roblim/fused_glass_lighting/hardware/kicad/fgl_g2/fgl_g2_3d.png

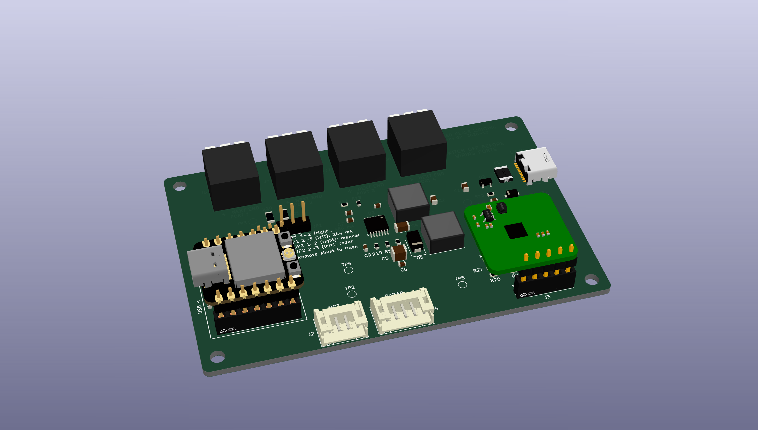
hardware/kicad/fgl_g2/fgl_g2_3d.png
