roblim/fused_glass_lighting/hardware/kicad/fgl_g2/fgl_g2_layout.png

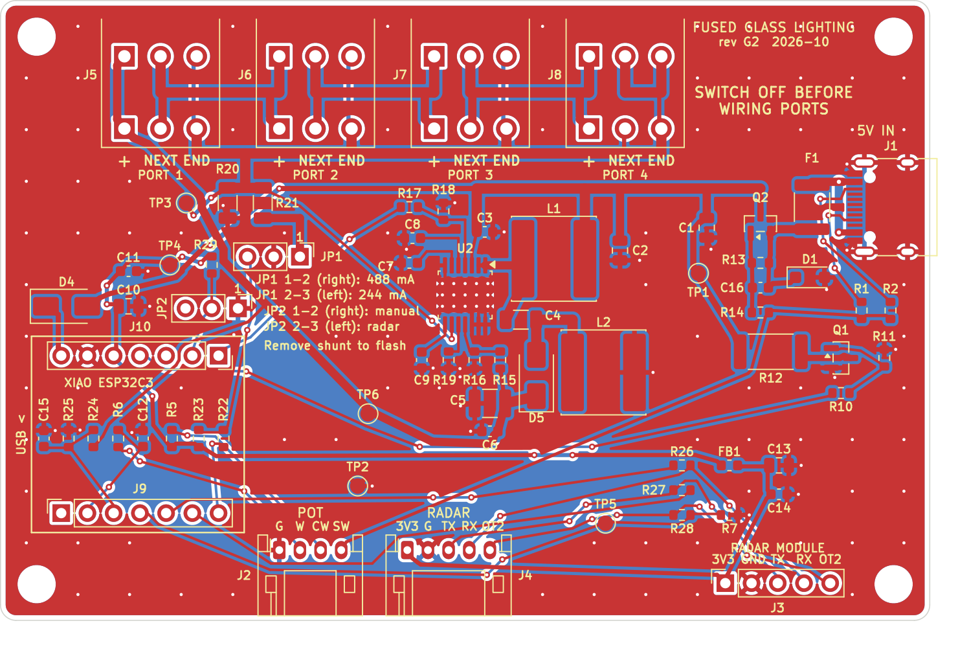
hardware/kicad/fgl_g2/fgl_g2_layout.png
