roblim/fused_glass_lighting/hardware/kicad/fgl_g2/bom.csv

Qty | References | Value | Footprint | MPN | Manufacturer | LCSC | Assembly
4 | C1,C2,C10,C13 | 10u 25V | C_0805_2012Metric | CL21A106KAYNNNE | Samsung | C15850 | JLCPCB
8 | C3,C8,C9,C11,C12,C14,C15,C16 | 100n 50V | C_0603_1608Metric | CC0603KRX7R9BB104 | YAGEO | C14663 | JLCPCB
1 | C4 | 10u 50V | C_1206_3216Metric | CL31A106KBHNNNE | Samsung | C13585 | JLCPCB
1 | C5 | 10u 100V | C_1210_3225Metric | GRM32EC72A106KE05L | Murata | C576517 | JLCPCB
1 | C6 | 100n 100V | C_0603_1608Metric | CL10B104KC8NNNC | Samsung | C15725 | JLCPCB
1 | C7 | 1u 50V | C_0603_1608Metric | CL10A105KB8NNNC | Samsung | C15849 | JLCPCB
1 | D1 | SMF6.0A | D_SOD-123F | SMF6.0A | Jingdao | C178260 | DNP
1 | D4 | SS14 | D_SMA | SS14 | MDD | C2480 | JLCPCB
1 | D5 | SS36 | D_SMA | SS36 | LGE | C2903825 | JLCPCB
1 | F1 | 2A hold | Fuse_1812_4532Metric | SMD1812B200TF/16 | Brightking | C269145 | JLCPCB
1 | FB1 | 600R@100MHz | L_0603_1608Metric | GZ1608D601TF | Sunlord | C1002 | JLCPCB
1 | J1 | USB-C (from bank) | USB_C_Receptacle_HRO_TYPE-C-31-M-12 | TYPE-C-31-M-12 | Korean Hroparts Elec | C165948 | JLCPCB
1 | J2 | POT 100k lin + SW | JST_PH_S4B-PH-K_1x04_P2.00mm_Horizontal | S4B-PH-K-S(LF)(SN) | JST | C157926 | JLCPCB
1 | J3 | LD2410S socket | PinSocket_1x05_P2.54mm_Vertical | HC-PM254-5.0H-1x5PZ | Hong Cheng | C27985230 | JLCPCB
1 | J4 | LD2410S cable | JST_PH_S5B-PH-K_1x05_P2.00mm_Horizontal | S5B-PH-K-S(LF)(SN) | JST | C157923 | JLCPCB
1 | J5 | PORT 1 | TerminalBlock_JILN_JL212R-3.5-03P_Horizontal | DG212R-THR-3.5-03P-13-1000A(H) | DEGSON | C7603454 | JLCPCB
1 | J6 | PORT 2 | TerminalBlock_JILN_JL212R-3.5-03P_Horizontal | DG212R-THR-3.5-03P-13-1000A(H) | DEGSON | C7603454 | JLCPCB
1 | J7 | PORT 3 | TerminalBlock_JILN_JL212R-3.5-03P_Horizontal | DG212R-THR-3.5-03P-13-1000A(H) | DEGSON | C7603454 | JLCPCB
1 | J8 | PORT 4 | TerminalBlock_JILN_JL212R-3.5-03P_Horizontal | DG212R-THR-3.5-03P-13-1000A(H) | DEGSON | C7603454 | JLCPCB
1 | J9 | XIAO socket 1-7 | PinSocket_1x07_P2.54mm_Vertical | HC-PM254-5.0H-1x7PZ | Hong Cheng | C27985232 | JLCPCB
1 | J10 | XIAO socket 8-14 | PinSocket_1x07_P2.54mm_Vertical | HC-PM254-5.0H-1x7PZ | Hong Cheng | C27985232 | JLCPCB
1 | JP1 | ISEL | PinHeader_1x03_P2.54mm_Vertical | 2.54-1*3P | BOOMELE | C49257 | JLCPCB
2 | JP1-shunt, JP2-shunt | 2.54 mm shunt for JP1 / JP2 | (loose part, open top) | 2.54 | BOOMELE | C5305 | loose
1 | JP2 | RADAR_MODE | PinHeader_1x03_P2.54mm_Vertical | 2.54-1*3P | BOOMELE | C49257 | JLCPCB
2 | L1,L2 | 10uH | L_Sunlord_SWPA8040S | SWPA8040S100MT | Sunlord | C37429 | JLCPCB
1 | Q1 | AO3400A | SOT-23 | AO3400A | AOS | C20917 | JLCPCB
1 | Q2 | AO3401A | SOT-23 | AO3401A | AOS | C15127 | JLCPCB
3 | R1,R2,R16 | 5.1k 1% | R_0603_1608Metric | 0603WAF5101T5E | UNI-ROYAL | C23186 | JLCPCB
1 | R5 | 47k 1% | R_0603_1608Metric | 0603WAF4702T5E | UNI-ROYAL | C25819 | JLCPCB
6 | R6,R17,R22,R26,R27,R28 | 1k 1% | R_0603_1608Metric | 0603WAF1001T5E | UNI-ROYAL | C21190 | JLCPCB
4 | R7,R11,R13,R23 | 100k 1% | R_0603_1608Metric | 0603WAF1003T5E | UNI-ROYAL | C25803 | JLCPCB
1 | R10 | 100R 1% | R_0603_1608Metric | 0603WAF1000T5E | UNI-ROYAL | C22775 | JLCPCB
1 | R12 | 33R 1% 1W | R_2512_6332Metric | 25121WF330JT4E | UNI-ROYAL | C53728 | JLCPCB
2 | R14,R25 | 10k 1% | R_0603_1608Metric | 0603WAF1002T5E | UNI-ROYAL | C25804 | JLCPCB
1 | R15 | 110k 1% | R_0603_1608Metric | 0603WAF1103T5E | UNI-ROYAL | C25805 | JLCPCB
1 | R18 | 2.2k 1% | R_0603_1608Metric | 0603WAF2201T5E | UNI-ROYAL | C4190 | JLCPCB
1 | R19 | 82k 1% | R_0603_1608Metric | 0603WAF8202T5E | UNI-ROYAL | C23254 | JLCPCB
2 | R20,R21 | 0.82R 1% | R_1206_3216Metric | 1206W4F820LT5E | UNI-ROYAL | C30568 | JLCPCB
1 | R24 | 120k 1% | R_0603_1608Metric | 0603WAF1203T5E | UNI-ROYAL | C25808 | JLCPCB
1 | R29 | 10k | R_0603_1608Metric | 0603WAF1002T5E | UNI-ROYAL | C25804 | JLCPCB
1 | U1 | XIAO ESP32C3 | (plugs into J9/J10; pre-soldered headers SKU) | 102010633 | Seeed Studio |  | hand
1 | U2 | TPS61500PWPR | Texas_HTSSOP-14-1EP_4.4x5mm_P0.65mm_EP3.4x5mm_Mask3.155x3.255mm_ThermalVias | TPS61500PWPR | TI | C71160 | JLCPCB
