roblim/fused_glass_lighting/hardware/kicad/fgl_g1/bom.csv

Qty | References | Value | Footprint | MPN | Manufacturer | LCSC | Assembly
4 | C1,C2,C3,C8 | 10u 25V | C_0805_2012Metric | CL21A106KAYNNNE | Samsung | C15850 | JLCPCB
4 | C4,C5,C6,C9 | 100n | C_0603_1608Metric | CC0603KRX7R9BB104 | YAGEO | C14663 | JLCPCB
1 | C7 | 1u | C_0603_1608Metric | CL10A105KB8NNNC | Samsung | C15849 | JLCPCB
1 | D1 | SMF6.0A | D_SOD-123F | SMF6.0A | Jingdao | C178260 | DNP
3 | D2,D3,D4 | SS14 | D_SMA | SS14 | MDD | C2480 | JLCPCB
1 | F1 | 0.75A hold | Fuse_1206_3216Metric | 1206L075THYR | Littelfuse | C99563 | JLCPCB
1 | J1 | USB-C (from bank) | USB_C_Receptacle_HRO_TYPE-C-31-M-12 | TYPE-C-31-M-12 | Korean Hroparts Elec | C165948 | JLCPCB
1 | J2 | POT 100k lin | JST_PH_S3B-PH-K_1x03_P2.00mm_Horizontal | S3B-PH-K-S(LF)(SN) | JST | C157929 | hand
1 | J3 | LD2410S | JST_PH_S5B-PH-K_1x05_P2.00mm_Horizontal | S5B-PH-K-S(LF)(SN) | JST | C157923 | hand
1 | J4 | FILAMENT 1 | JST_PH_S2B-PH-K_1x02_P2.00mm_Horizontal | S2B-PH-K-S(LF)(SN) | JST | C173752 | hand
1 | J5 | FILAMENT 2 | JST_PH_S2B-PH-K_1x02_P2.00mm_Horizontal | S2B-PH-K-S(LF)(SN) | JST | C173752 | hand
2 | L1,L2 | 47uH | L_Sunlord_SWPA6045S | SWPA6045S470MT | Sunlord | C36414 | JLCPCB
1 | Q1 | AO3400A | SOT-23 | AO3400A | AOS | C20917 | JLCPCB
2 | R1,R2 | 5.1k 1% | R_0603_1608Metric | 0603WAF5101T5E | UNI-ROYAL | C23186 | JLCPCB
2 | R3,R4 | 0.33R 1% | R_1206_3216Metric | 1206W4F330LT5E | UNI-ROYAL | C25337 | JLCPCB
1 | R5 | 47k 1% | R_0603_1608Metric | 0603WAF4702T5E | UNI-ROYAL | C25819 | JLCPCB
1 | R6 | 1k | R_0603_1608Metric | 0603WAF1001T5E | UNI-ROYAL | C21190 | JLCPCB
2 | R7,R11 | 100k | R_0603_1608Metric | 0603WAF1003T5E | UNI-ROYAL | C25803 | JLCPCB
1 | R8 | 2.2k 1% | R_0603_1608Metric | 0603WAF2201T5E | UNI-ROYAL | C4190 | JLCPCB
1 | R9 | 10k 1% | R_0603_1608Metric | 0603WAF1002T5E | UNI-ROYAL | C25804 | JLCPCB
1 | R10 | 100R | R_0603_1608Metric | 0603WAF1000T5E | UNI-ROYAL | C22775 | JLCPCB
1 | R12 | 33R 1W 2512 | R_2512_6332Metric | 25121WF330JT4E | UNI-ROYAL | C53728 | JLCPCB
1 | U1 | XIAO ESP32C3 | XIAO_ESP32C3_Castellated | 113991054 | Seeed Studio |  | hand
2 | U2,U3 | AL8860WT-7 | TSOT-23-5 | AL8860WT-7 | Diodes Inc | C125330 | JLCPCB
