roblim/fused_glass_lighting/hardware/kicad/fgl_g2/fgl_g2_assembly.pdf

## J6 R²⁰

# H2 R²²

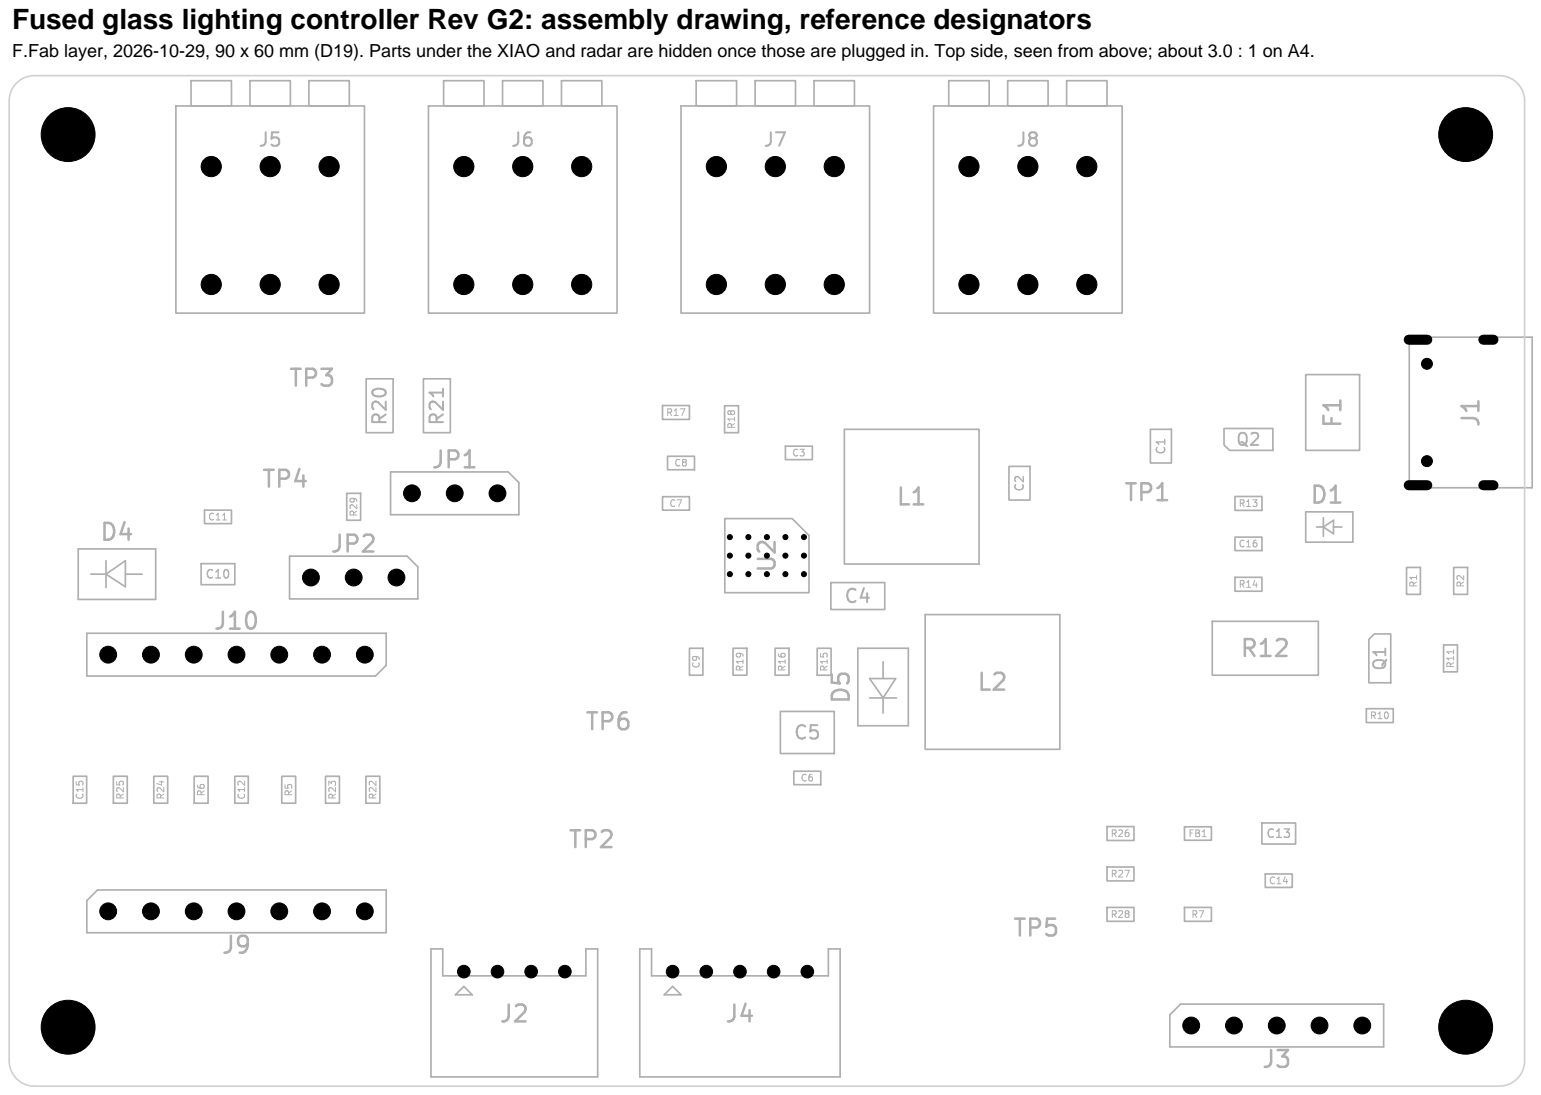
[picture p3: page 1]

Fused glass lighting controller Rev G2: assembly drawing, reference designators
F.Fab layer, 2026-10-29, 90 x 60 mm (D19). Parts under the XIAO and radar are hidden once those are plugged in. Top side, seen from above; about 3.0 : 1 on A4.

# Fused glass lighting controller Rev G2: parts by reference

From bom.csv, 2026-10-29. "Assembly" says who fits the part: JLCPCB, or you (plug-in modules, the JP1 and JP2 shunts).

C1 | 10u 25V | CL21A106KAYNNNE
C2 | 10u 25V | CL21A106KAYNNNE
C3 | 100n 50V | CC0603KRX7R9BB104
C4 | 10u 50V | CL31A106KBHNNNE
C5 | 10u 100V | GRM32EC72A106KE05L
C6 | 100n 100V | CL10B104KC8NNNC
C7 | 1u 50V | CL10A105KB8NNNC
C8 | 100n 50V | CC0603KRX7R9BB104
C9 | 100n 50V | CC0603KRX7R9BB104
C10 | 10u 25V | CL21A106KAYNNNE
C11 | 100n 50V | CC0603KRX7R9BB104
C12 | 100n 50V | CC0603KRX7R9BB104
C13 | 10u 25V | CL21A106KAYNNNE
C14 | 100n 50V | CC0603KRX7R9BB104
C15 | 100n 50V | CC0603KRX7R9BB104
C16 | 100n 50V | CC0603KRX7R9BB104
D1 | SMF6.0A | SMF6.0A [DNP]
D4 | SS14 | SS14
D5 | SS36 | SS36
F1 | 2A hold | SMD1812B200TF/16
FB1 | 600R@100MHz | GZ1608D601TF
J1 | USB-C (from bank) | TYPE-C-31-M-12
J2 | POT 100k lin + SW | S4B-PH-K-S(LF)(SN)
J3 | LD2410S socket | HC-PM254-5.0H-1x5PZ
J4 | LD2410S cable | S5B-PH-K-S(LF)(SN)
J5 | PORT 1 | DG212R-THR-3.5-03P-13-
J6 | PORT 2 | DG212R-THR-3.5-03P-13-
J7 | PORT 3 | DG212R-THR-3.5-03P-13-
J8 | PORT 4 | DG212R-THR-3.5-03P-13-
J9 | XIAO socket 1-7 | HC-PM254-5.0H-1x7PZ
J10 | XIAO socket 8-14 | HC-PM254-5.0H-1x7PZ
JP1 | ISEL | 2.54-1*3P

### JP1-shunt 2.54 mm shunt for JP1 / JP22.54 [loose] JP2-shunt 2.54 mm shunt for JP1 / JP22.54 [loose]

JP2 | RADAR_MODE | 2.54-1*3P
L1 | 10uH | SWPA8040S100MT
L2 | 10uH | SWPA8040S100MT
Q1 | AO3400A | AO3400A
Q2 | AO3401A | AO3401A
R1 | 5.1k 1% | 0603WAF5101T5E
R2 | 5.1k 1% | 0603WAF5101T5E
R5 | 47k 1% | 0603WAF4702T5E
R6 | 1k 1% | 0603WAF1001T5E
R7 | 100k 1% | 0603WAF1003T5E
R10 | 100R 1% | 0603WAF1000T5E
R11 | 100k 1% | 0603WAF1003T5E
R12 | 33R 1% 1W | 25121WF330JT4E
R13 | 100k 1% | 0603WAF1003T5E
R14 | 10k 1% | 0603WAF1002T5E
R15 | 110k 1% | 0603WAF1103T5E
R16 | 5.1k 1% | 0603WAF5101T5E
R17 | 1k 1% | 0603WAF1001T5E
R18 | 2.2k 1% | 0603WAF2201T5E
R19 | 82k 1% | 0603WAF8202T5E
R20 | 0.82R 1% | 1206W4F820LT5E
R21 | 0.82R 1% | 1206W4F820LT5E
R22 | 1k 1% | 0603WAF1001T5E
R23 | 100k 1% | 0603WAF1003T5E
R24 | 120k 1% | 0603WAF1203T5E
R25 | 10k 1% | 0603WAF1002T5E
R26 | 1k 1% | 0603WAF1001T5E
R27 | 1k 1% | 0603WAF1001T5E
R28 | 1k 1% | 0603WAF1001T5E
R29 | 10k | 0603WAF1002T5E
U1 | XIAO ESP32C3 | 113991054 [hand]
U2 | TPS61500PWPR | TPS61500PWPR
