roblim/fused_glass_lighting/hardware/kicad/fgl_g1/verification.txt

PASS: 24 nets, 106 connections, 11 no-connects, 46 parts; footprints and BOM fields OK
