roblim/fused_glass_lighting/hardware/kicad/fgl_rev_f/verification.txt

PASS: 19 nets, 62 connections, 5 no-connects, 22 parts; footprint/BOM checks not applicable
