roblim/fused_glass_lighting/hardware/kicad/fgl_g2/fgl_g2.pdf

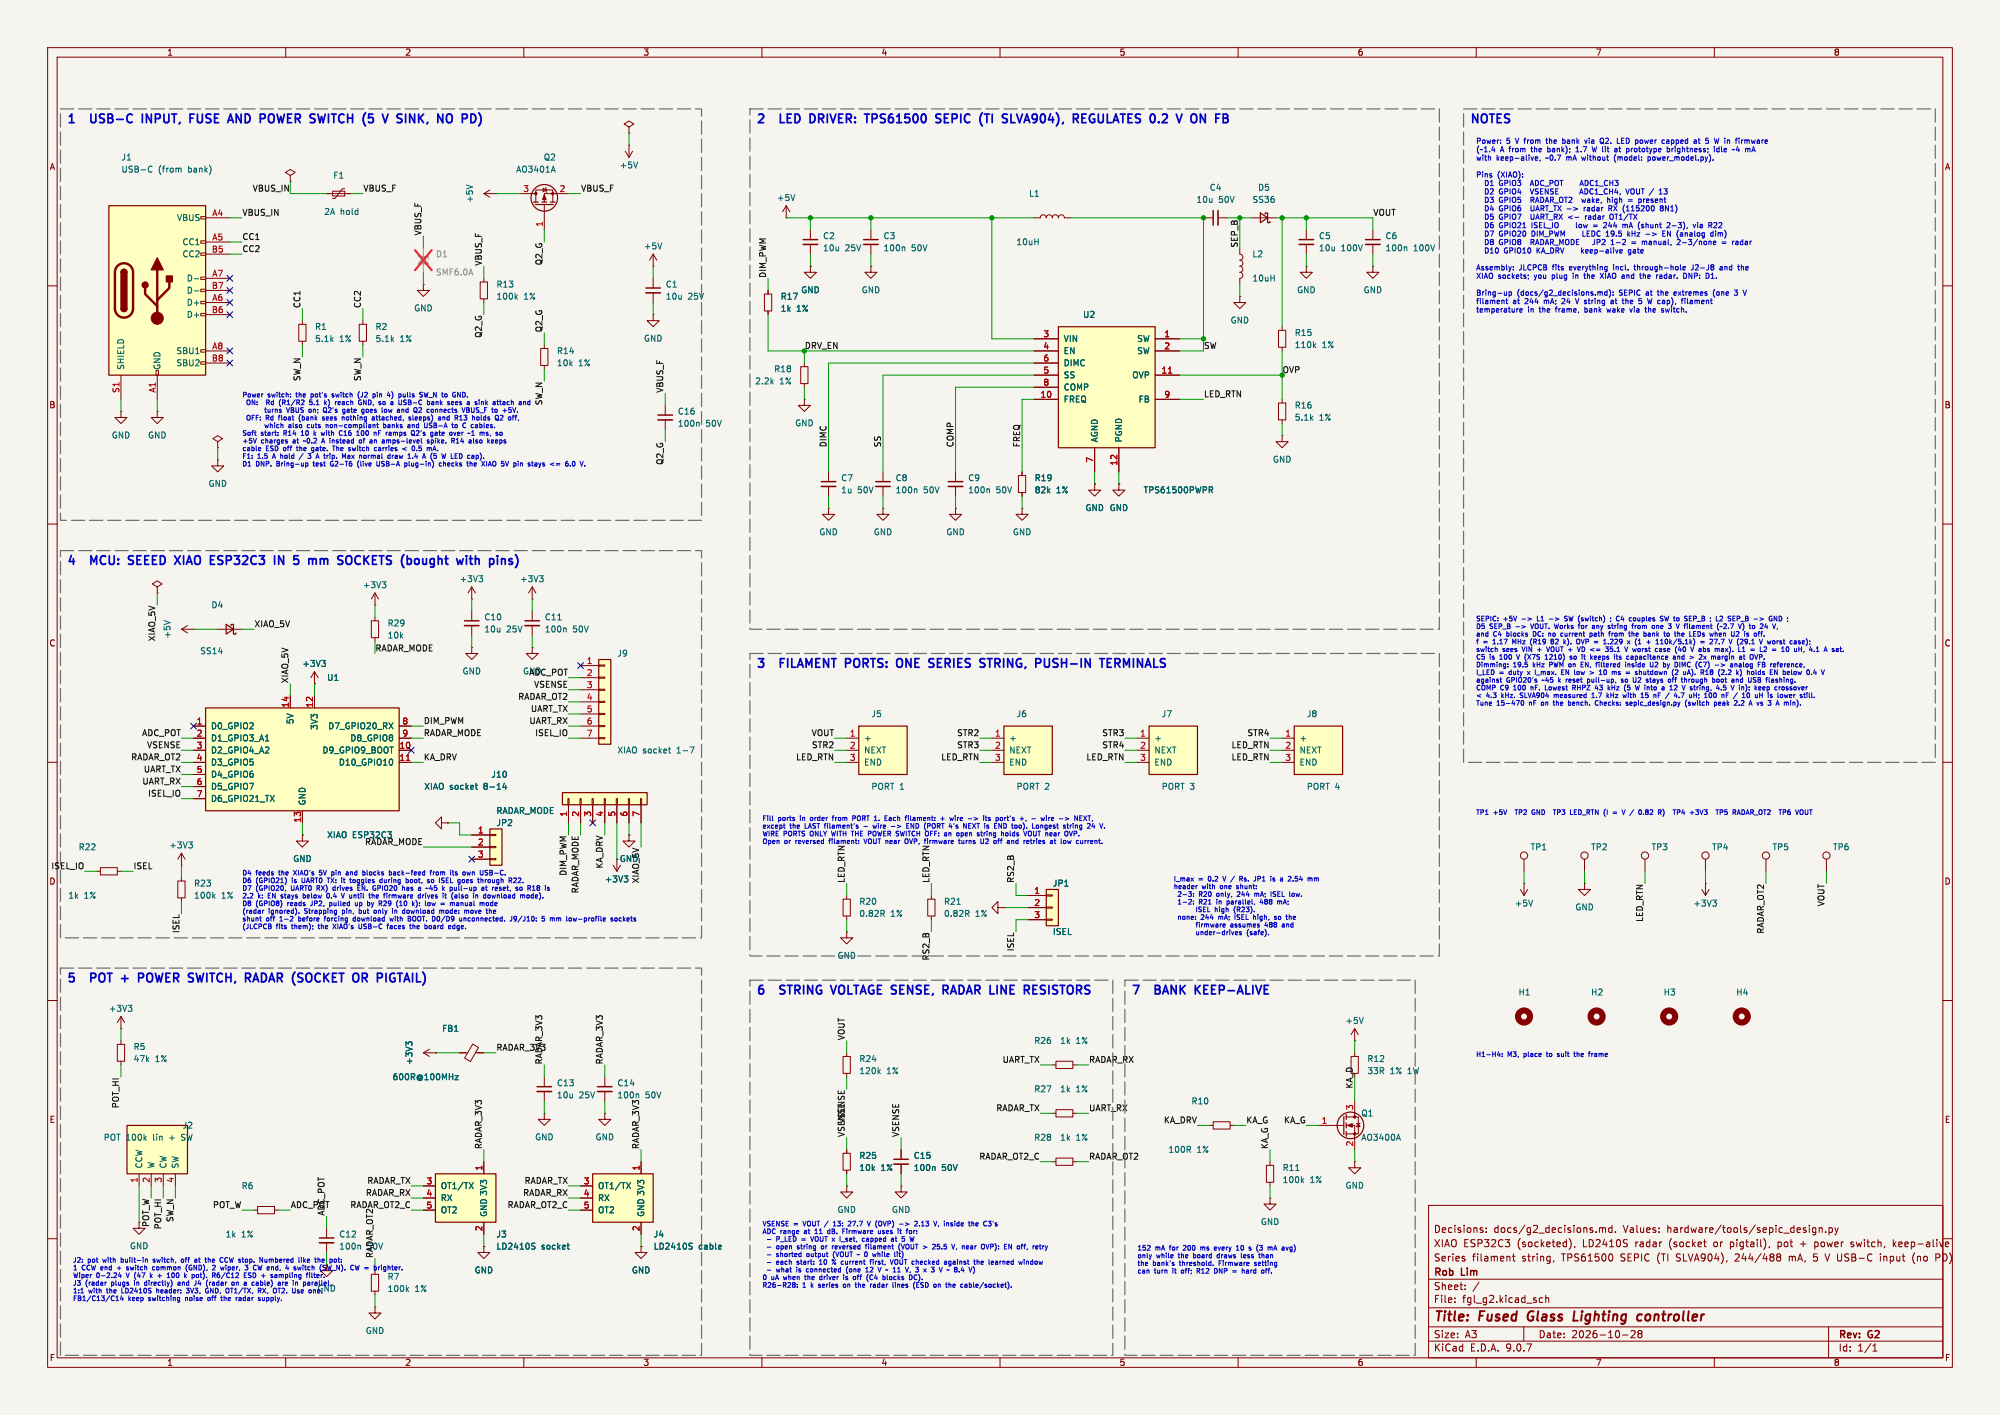
[picture p4: page 1]

Power: 5 V from the bank via Q2. LED power capped at 5 W in firmware

7 PGND 12 SW 1 SW 2 OVP 11 FB 9 U2 TPS61500PWPR

7 PGND 12 SW 1 SW 2 OVP 11 FB 9 R19

ISEL high (R23). none: 244 mA; ISEL high, so the

- shorted output (VOUT ~ 0 while lit)

152 mA for 200 ms every 10 s (3 mA avg) only while the board draws less than
