roblim/fused_glass_lighting/hardware/kicad/fgl_g1/fgl_g1.pdf

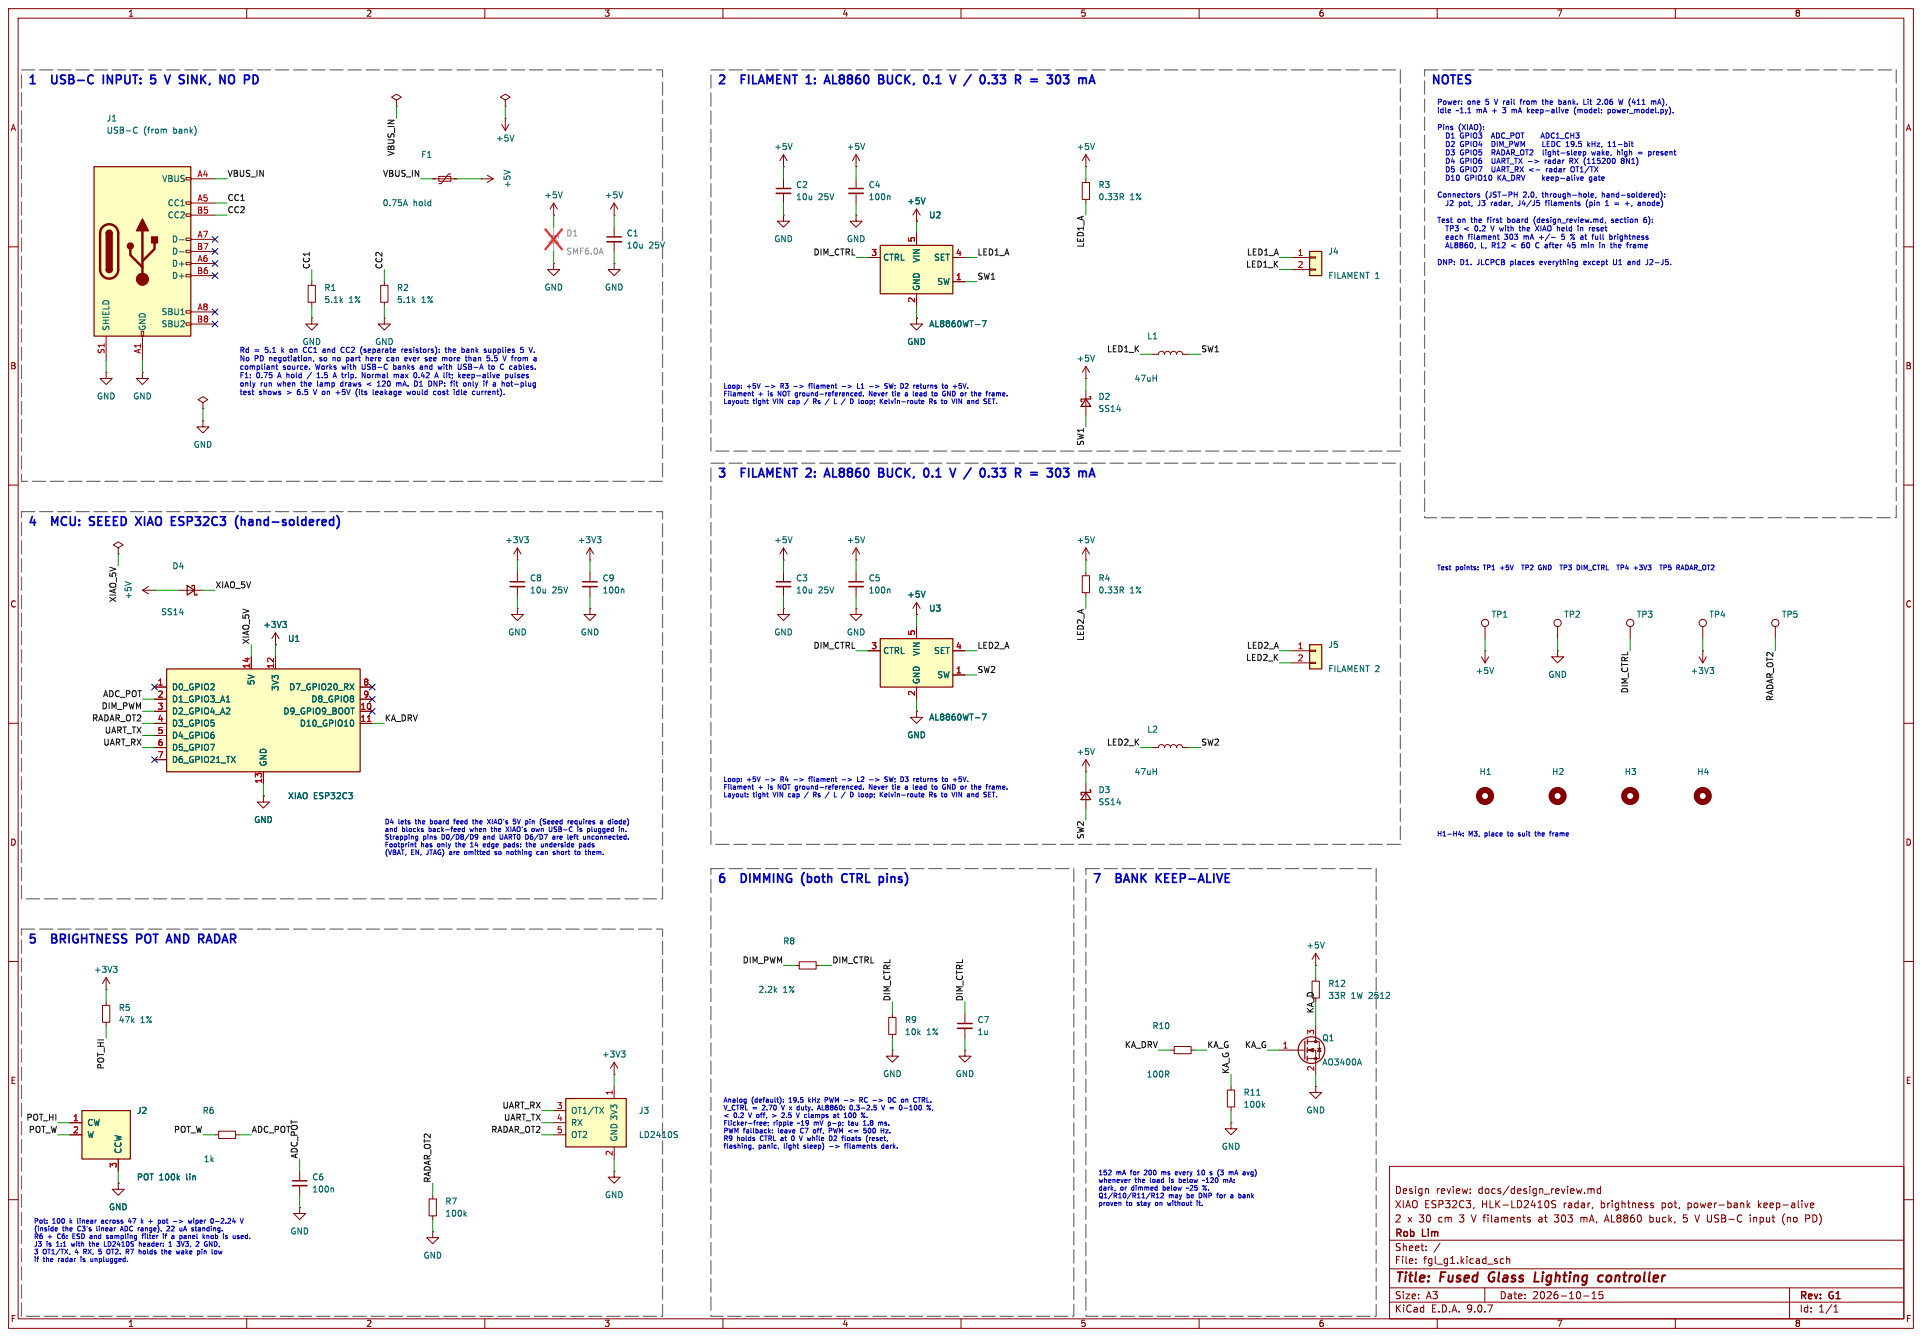
[picture p5: page 1]

Power: one 5 V rail from the bank. Lit 2.06 W (411 mA),

2 SET 4 SW 1 +5V U2AL8860WT-7 CTRL 3 VIN

4 MCU: SEEED XIAO ESP32C3 (hand-soldered)

Design review: docs/design_review.md R12
