roblim/fused_glass_lighting/hardware/kicad/fgl_rev_f/fgl_rev_f.pdf

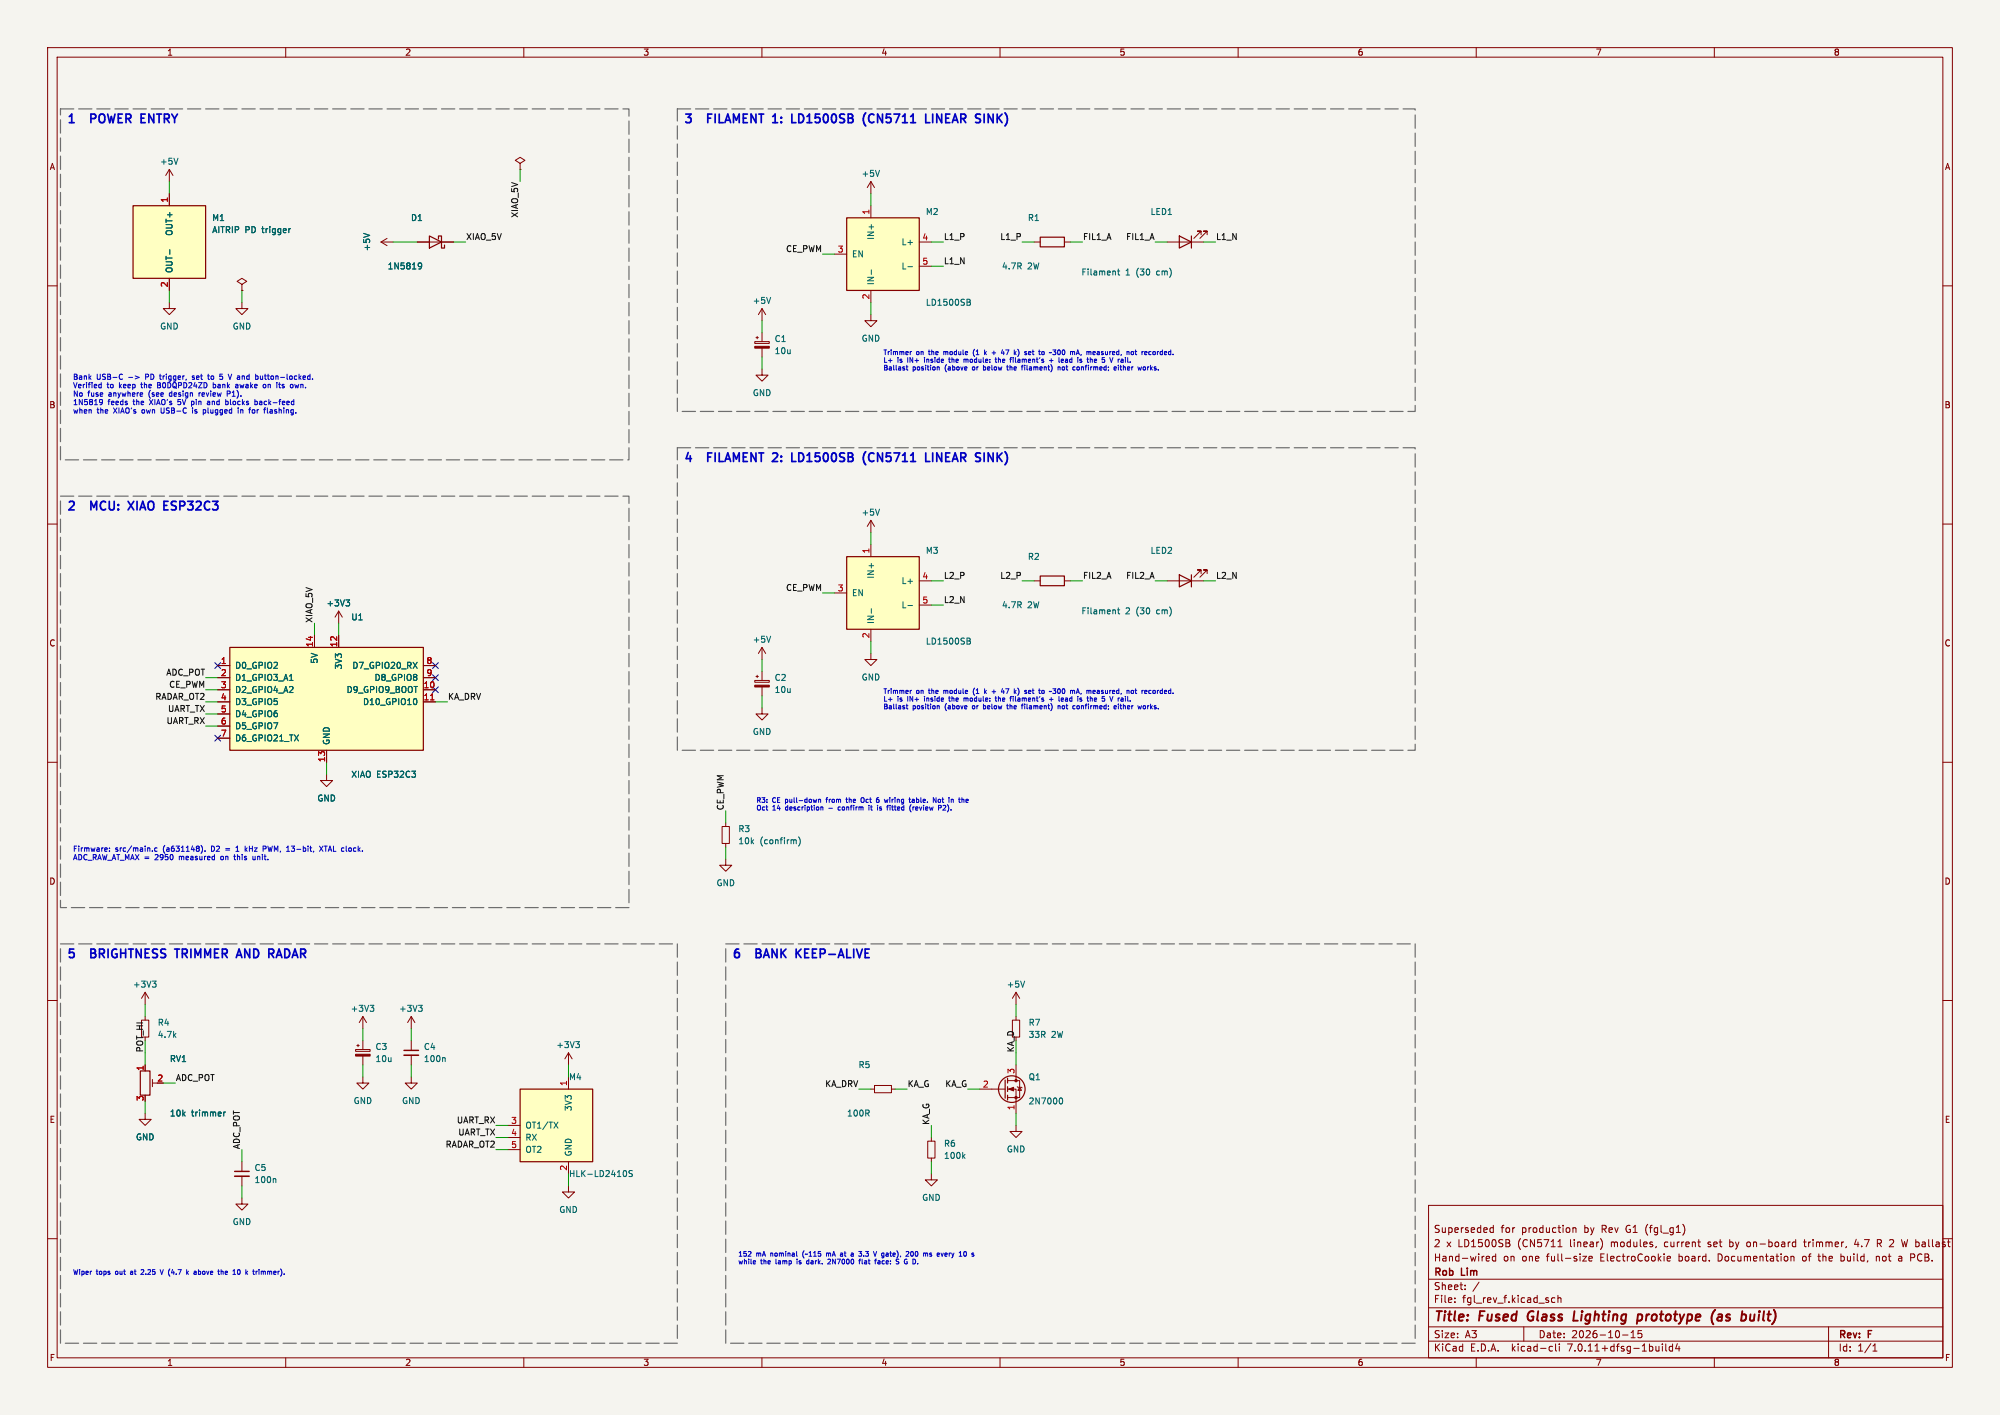
[picture p6: page 1]

3 M1 OUT+ AITRIP PD trigger 1 OUT- 2 +5V D1

1 OUT- 2 M1 AITRIP PD trigger

5 BRIGHTNESS TRIMMER AND RADAR

Wiper tops out at 2.25 V (4.7 k above the 10 k trimmer).
