roblim/fused_glass_lighting/hardware/kicad/fgl_g2/fgl_g2.kicad_pcb

## KiCad design hardware/kicad/fgl_g2/fgl_g2.kicad_pcb (2026-10-30)

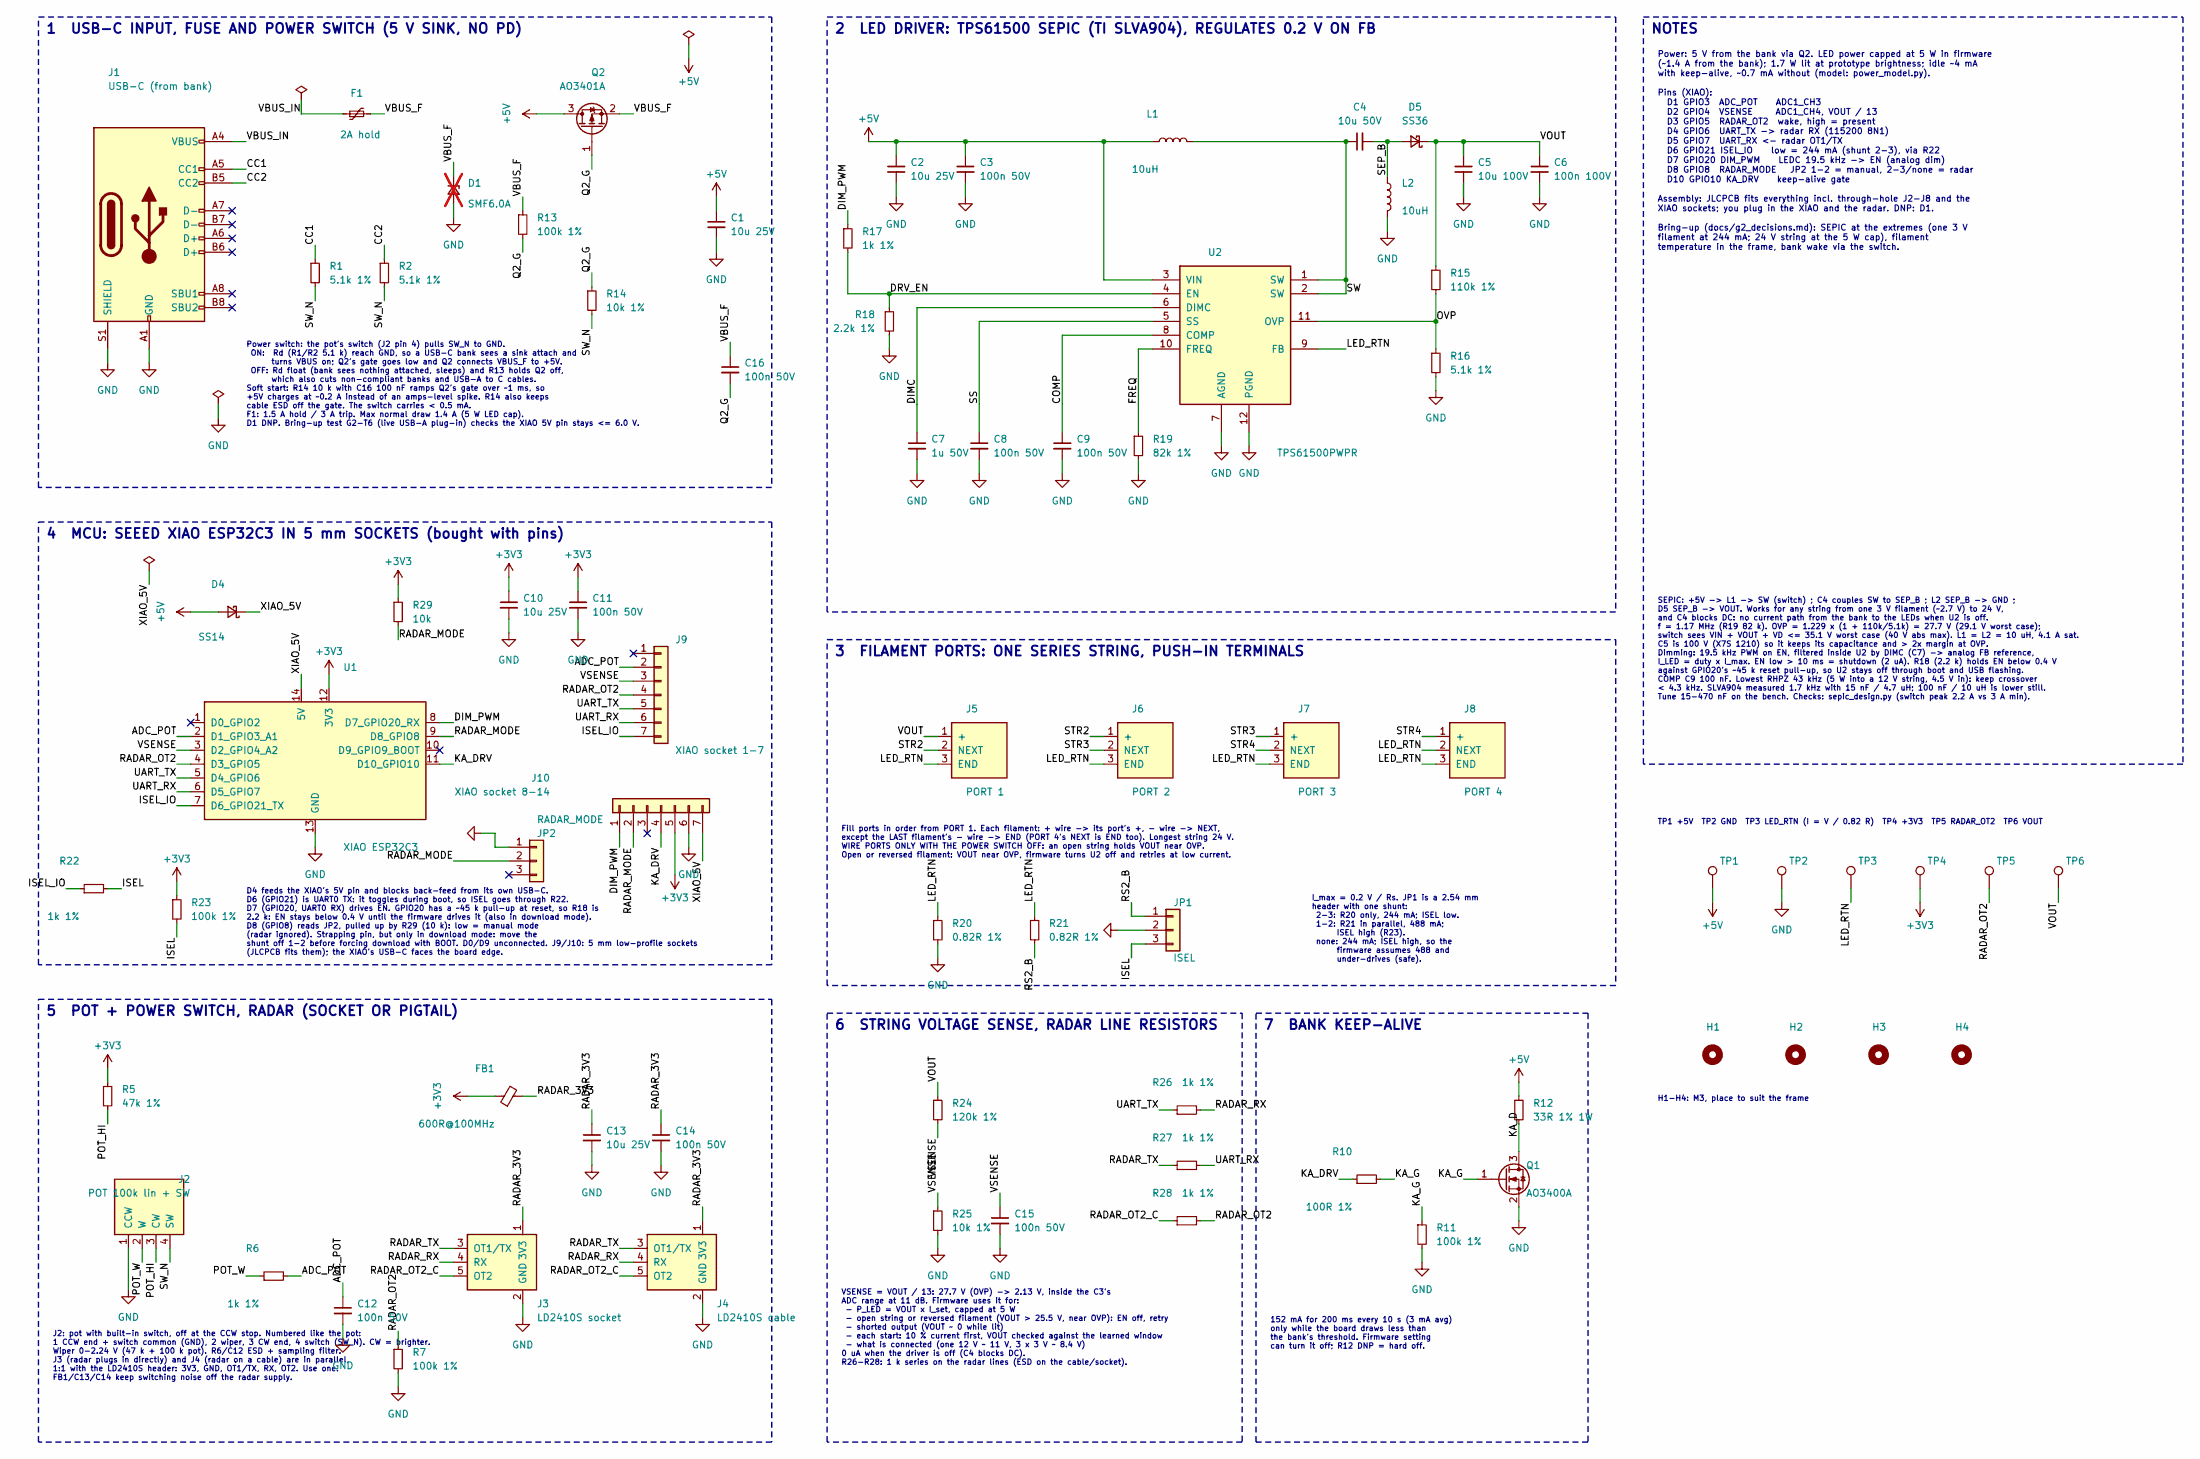
[picture p7: schematic fgl_g2.kicad_sch, Fused Glass Lighting controller]

Parts:
C1, C2, C10, C13: 10u 25V; C_0805_2012Metric; MPN CL21A106KAYNNNE; LCSC C15850
C3, C8, C9, C11, C12, C14, C15, C16: 100n 50V; C_0603_1608Metric; MPN CC0603KRX7R9BB104; LCSC C14663
C4: 10u 50V; C_1206_3216Metric; MPN CL31A106KBHNNNE; LCSC C13585
C5: 10u 100V; C_1210_3225Metric; MPN GRM32EC72A106KE05L; LCSC C576517
C6: 100n 100V; C_0603_1608Metric; MPN CL10B104KC8NNNC; LCSC C15725
C7: 1u 50V; C_0603_1608Metric; MPN CL10A105KB8NNNC; LCSC C15849
D1: SMF6.0A; D_SOD-123F; MPN SMF6.0A; LCSC C178260; not fitted
D4: SS14; D_SMA; MPN SS14; LCSC C2480
D5: SS36; D_SMA; MPN SS36; LCSC C2903825
F1: 2A hold; Fuse_1812_4532Metric; MPN SMD1812B200TF/16; LCSC C269145
FB1: 600R@100MHz; L_0603_1608Metric; MPN GZ1608D601TF; LCSC C1002
H1, H2, H3, H4: M3; MountingHole_3.2mm_M3
J1: USB-C (from bank); USB_C_Receptacle_HRO_TYPE-C-31-M-12; MPN TYPE-C-31-M-12; LCSC C165948
J2: POT 100k lin + SW; JST_PH_S4B-PH-K_1x04_P2.00mm_Horizontal; MPN S4B-PH-K-S(LF)(SN); LCSC C157926
J3: LD2410S socket; PinSocket_1x05_P2.54mm_Vertical; MPN HC-PM254-5.0H-1x5PZ; LCSC C27985230
J4: LD2410S cable; JST_PH_S5B-PH-K_1x05_P2.00mm_Horizontal; MPN S5B-PH-K-S(LF)(SN); LCSC C157923
J5: PORT 1; TerminalBlock_JILN_JL212R-3.5-03P_Horizontal; MPN DG212R-THR-3.5-03P-13-1000A(H); LCSC C7603454
J6: PORT 2; TerminalBlock_JILN_JL212R-3.5-03P_Horizontal; MPN DG212R-THR-3.5-03P-13-1000A(H); LCSC C7603454
J7: PORT 3; TerminalBlock_JILN_JL212R-3.5-03P_Horizontal; MPN DG212R-THR-3.5-03P-13-1000A(H); LCSC C7603454
J8: PORT 4; TerminalBlock_JILN_JL212R-3.5-03P_Horizontal; MPN DG212R-THR-3.5-03P-13-1000A(H); LCSC C7603454
J9: XIAO socket 1-7; PinSocket_1x07_P2.54mm_Vertical; MPN HC-PM254-5.0H-1x7PZ; LCSC C27985232
J10: XIAO socket 8-14; PinSocket_1x07_P2.54mm_Vertical; MPN HC-PM254-5.0H-1x7PZ; LCSC C27985232
JP1: ISEL; PinHeader_1x03_P2.54mm_Vertical; MPN 2.54-1*3P; LCSC C49257
JP2: RADAR_MODE; PinHeader_1x03_P2.54mm_Vertical; MPN 2.54-1*3P; LCSC C49257
L1, L2: 10uH; L_Sunlord_SWPA8040S; MPN SWPA8040S100MT; LCSC C37429
Q1: AO3400A; SOT-23; MPN AO3400A; LCSC C20917
Q2: AO3401A; SOT-23; MPN AO3401A; LCSC C15127
R1, R2, R16: 5.1k 1%; R_0603_1608Metric; MPN 0603WAF5101T5E; LCSC C23186
R5: 47k 1%; R_0603_1608Metric; MPN 0603WAF4702T5E; LCSC C25819
R6, R17, R22, R26, R27, R28: 1k 1%; R_0603_1608Metric; MPN 0603WAF1001T5E; LCSC C21190
R7, R11, R13, R23: 100k 1%; R_0603_1608Metric; MPN 0603WAF1003T5E; LCSC C25803
R10: 100R 1%; R_0603_1608Metric; MPN 0603WAF1000T5E; LCSC C22775
R12: 33R 1% 1W; R_2512_6332Metric; MPN 25121WF330JT4E; LCSC C53728
R14, R25: 10k 1%; R_0603_1608Metric; MPN 0603WAF1002T5E; LCSC C25804
R15: 110k 1%; R_0603_1608Metric; MPN 0603WAF1103T5E; LCSC C25805
R18: 2.2k 1%; R_0603_1608Metric; MPN 0603WAF2201T5E; LCSC C4190
R19: 82k 1%; R_0603_1608Metric; MPN 0603WAF8202T5E; LCSC C23254
R20, R21: 0.82R 1%; R_1206_3216Metric; MPN 1206W4F820LT5E; LCSC C30568
R24: 120k 1%; R_0603_1608Metric; MPN 0603WAF1203T5E; LCSC C25808
R29: 10k; R_0603_1608Metric; MPN 0603WAF1002T5E; LCSC C25804
TP1: +5V; TestPoint_Pad_D1.5mm
TP2: GND; TestPoint_Pad_D1.5mm
TP3: LED_RTN; TestPoint_Pad_D1.5mm
TP4: +3V3; TestPoint_Pad_D1.5mm
TP5: RADAR_OT2; TestPoint_Pad_D1.5mm
TP6: VOUT; TestPoint_Pad_D1.5mm
U1: XIAO ESP32C3; MPN 113991054
U2: TPS61500PWPR; Texas_HTSSOP-14-1EP_4.4x5mm_P0.65mm_EP3.4x5mm_Mask3.155x3.2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; MPN TPS61500PWPR; LCSC C71160

Connections:
+3V3: C10.1, C11.1, FB1.1, J10.5, R5.1, R23.1, R29.1, TP4.1, U1.12 (3V3)
+5V: C1.1, C2.1, C3.1, D4.2 (A), L1.1, Q2.3 (D), R12.1, TP1.1, U2.3 (VIN)
/ADC_POT: C12.1, J9.2, R6.2, U1.2 (D1_GPIO3_A1)
/CC1: J1.A5 (CC1), R1.1
/CC2: J1.B5 (CC2), R2.1
/COMP: C9.1, U2.8 (COMP)
/DIMC: C7.1, U2.6 (DIMC)
/DIM_PWM: J10.1, R17.1, U1.8 (D7_GPIO20_RX)
/DRV_EN: R17.2, R18.1, U2.4 (EN)
/FREQ: R19.1, U2.10 (FREQ)
/ISEL: JP1.3, R22.2, R23.2
/ISEL_IO: J9.7, R22.1, U1.7 (D6_GPIO21_TX)
/KA_D: Q1.3 (D), R12.2
/KA_DRV: J10.4, R10.1, U1.11 (D10_GPIO10)
/KA_G: Q1.1 (G), R10.2, R11.1
/LED_RTN: J5.3 (END), J6.3 (END), J7.3 (END), J8.2 (NEXT), J8.3 (END), R20.1, R21.1, TP3.1, U2.9 (FB)
/OVP: R15.2, R16.1, U2.11 (OVP)
/POT_HI: J2.3 (CW), R5.2
/POT_W: J2.2 (W), R6.1
/Q2_G: C16.2, Q2.1 (G), R13.2, R14.1
/RADAR_3V3: C13.1, C14.1, FB1.2, J3.1 (3V3), J4.1 (3V3)
/RADAR_MODE: J10.2, JP2.2, R29.2, U1.9 (D8_GPIO8)
/RADAR_OT2: J9.4, R7.1, R28.2, TP5.1, U1.4 (D3_GPIO5)
/RADAR_OT2_C: J3.5 (OT2), J4.5 (OT2), R28.1
/RADAR_RX: J3.4 (RX), J4.4 (RX), R26.2
/RADAR_TX: J3.3 (OT1/TX), J4.3 (OT1/TX), R27.1
/RS2_B: JP1.1, R21.2
/SEP_B: C4.2, D5.2 (A), L2.1
/SS: C8.1, U2.5 (SS)
/STR2: J5.2 (NEXT), J6.1 (+)
/STR3: J6.2 (NEXT), J7.1 (+)
/STR4: J7.2 (NEXT), J8.1 (+)
/SW: C4.1, L1.2, U2.1 (SW), U2.2 (SW)
/SW_N: J2.4 (SW), R1.2, R2.2, R14.2
/UART_RX: J9.6, R27.2, U1.6 (D5_GPIO7)
/UART_TX: J9.5, R26.1, U1.5 (D4_GPIO6)
/VBUS_F: C16.1, D1.1 (K), F1.2, Q2.2 (S), R13.1
/VBUS_IN: F1.1, J1.A4 (VBUS), J1.A9 (VBUS), J1.B4 (VBUS), J1.B9 (VBUS)
/VOUT: C5.1, C6.1, D5.1 (K), J5.1 (+), R15.1, R24.1, TP6.1
/VSENSE: C15.1, J9.3, R24.2, R25.1, U1.3 (D2_GPIO4_A2)
/XIAO_5V: D4.1 (K), J10.7, U1.14 (5V)
GND: C1.2, C2.2, C3.2, C5.2, C6.2, C7.2, C8.2, C9.2, C10.2, C11.2, C12.2, C13.2, C14.2, C15.2, D1.2 (A), J1.A1 (GND), J1.A12 (GND), J1.B1 (GND), J1.B12 (GND), J1.S1 (SHIELD), J2.1 (CCW), J3.2 (GND), J4.2 (GND), J10.6, JP1.2, JP2.1, L2.2, Q1.2 (S), R7.2, R11.2, R16.2, R18.2, R19.2, R20.2, R25.2, TP2.1, U1.13 (GND), U2.7 (AGND), U2.12 (PGND), U2.13 (PGND), U2.14 (PGND), U2.15 (EP)

Notes on the sheet:
H1-H4: M3, place to suit the frame
1 USB-C INPUT, FUSE AND POWER SWITCH (5 V SINK, NO PD)
7 BANK KEEP-ALIVE
2 LED DRIVER: TPS61500 SEPIC (TI SLVA904), REGULATES 0.2 V ON FB
TP1 +5V TP2 GND TP3 LED_RTN (I = V / 0.82 R) TP4 +3V3 TP5 RADAR_OT2 TP6 VOUT
3 FILAMENT PORTS: ONE SERIES STRING, PUSH-IN TERMINALS
152 mA for 200 ms every 10 s (3 mA avg) only while the board draws less than the bank's threshold. Firmware setting can turn it off; R12 DNP = hard off.
VSENSE = VOUT / 13: 27.7 V (OVP) -> 2.13 V, inside the C3's ADC range at 11 dB. Firmware uses it for: - P_LED = VOUT x I_set, capped at 5 W - open string or reversed filament (VOUT > 25.5 V, near OVP): EN off, retry - shorted output (VOUT ~ 0 while lit) - each start: 10 % current first, VOUT checke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
5 POT + POWER SWITCH, RADAR (SOCKET OR PIGTAIL)
D4 feeds the XIAO's 5V pin and blocks back-feed from its own USB-C. D6 (GPIO21) is UART0 TX: it toggles during boot, so ISEL goes through R22. D7 (GPIO20, UART0 RX) drives EN. GPIO20 has a ~45 k pull-up at reset, so R18 is 2.2 k: EN stays below 0.4 V until the firmware drives it (also in download m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
6 STRING VOLTAGE SENSE, RADAR LINE RESISTORS
Power: 5 V from the bank via Q2. LED power capped at 5 W in firmware (~1.4 A from the bank); 1.7 W lit at prototype brightness; idle ~4 mA with keep-alive, ~0.7 mA without (model: power_model.py). Pins (XIAO): D1 GPIO3 ADC_POT ADC1_CH3 D2 GPIO4 VSENSE ADC1_CH4, VOUT / 13 D3 GPIO5 RADAR_OT2 wake, hi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
SEPIC: +5V -> L1 -> SW (switch) ; C4 couples SW to SEP_B ; L2 SEP_B -> GND ; D5 SEP_B -> VOUT. Works for any string from one 3 V filament (~2.7 V) to 24 V, and C4 blocks DC: no current path from the bank to the LEDs when U2 is off. f = 1.17 MHz (R19 82 k). OVP = 1.229 x (1 + 110k/5.1k) = 27.7 V (29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
Fill ports in order from PORT 1. Each filament: + wire -> its port's +, - wire -> NEXT, except the LAST filament's - wire -> END (PORT 4's NEXT is END too). Longest string 24 V. WIRE PORTS ONLY WITH THE POWER SWITCH OFF: an open string holds VOUT near OVP. Open or reversed filament: VOUT near OVP, 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
NOTES
I_max = 0.2 V / Rs. JP1 is a 2.54 mm header with one shunt: 2-3: R20 only, 244 mA; ISEL low. 1-2: R21 in parallel, 488 mA; ISEL high (R23). none: 244 mA; ISEL high, so the firmware assumes 488 and under-drives (safe).
4 MCU: SEEED XIAO ESP32C3 IN 5 mm SOCKETS (bought with pins)
J2: pot with built-in switch, off at the CCW stop. Numbered like the pot: 1 CCW end + switch common (GND), 2 wiper, 3 CW end, 4 switch (SW_N). CW = brighter. Wiper 0-2.24 V (47 k + 100 k pot). R6/C12 ESD + sampling filter. J3 (radar plugs in directly) and J4 (radar on a cable) are in parallel, 1:1 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
Power switch: the pot's switch (J2 pin 4) pulls SW_N to GND. ON: Rd (R1/R2 5.1 k) reach GND, so a USB-C bank sees a sink attach and turns VBUS on; Q2's gate goes low and Q2 connects VBUS_F to +5V. OFF: Rd float (bank sees nothing attached, sleeps) and R13 holds Q2 off, which also cuts non-compliant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

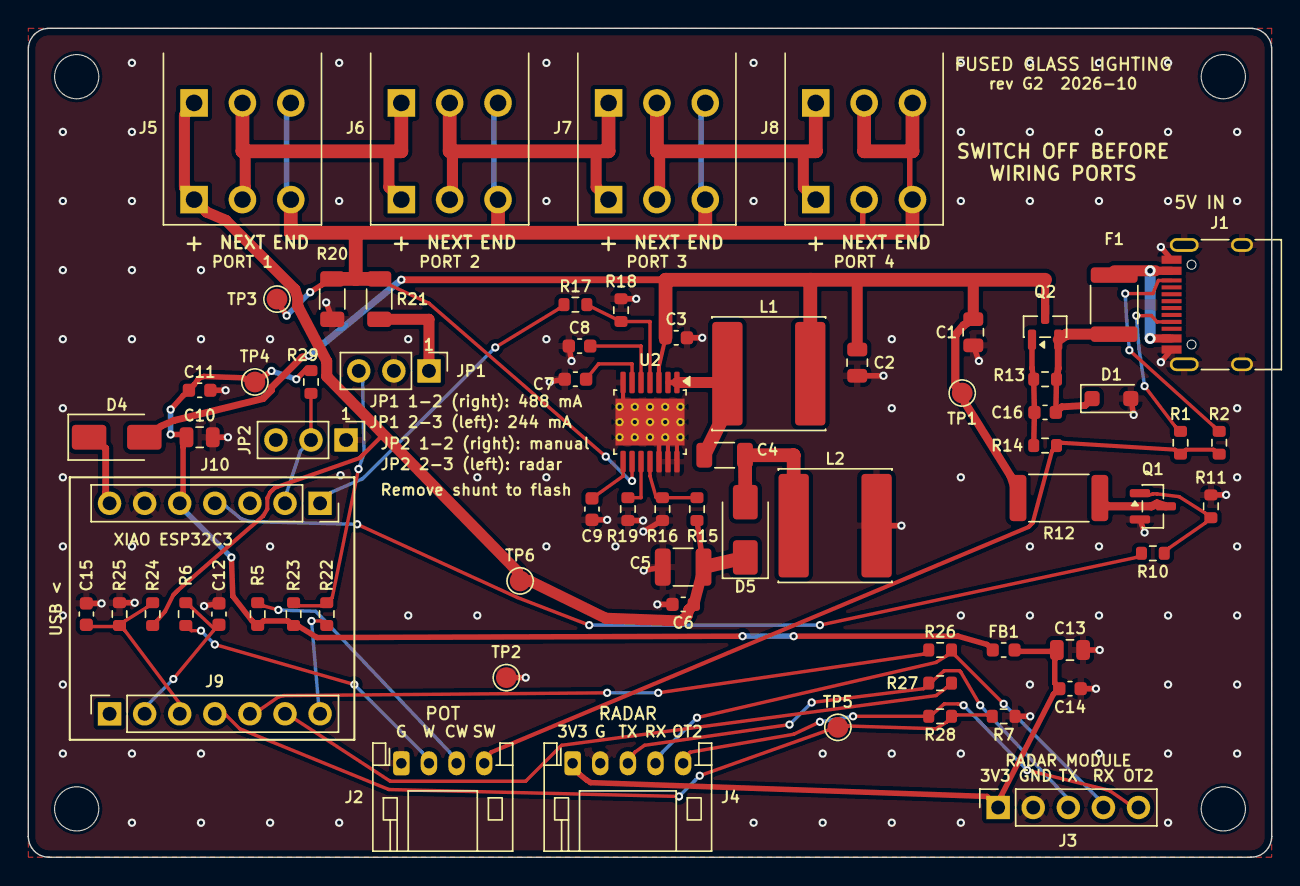
[picture p8: board fgl_g2.kicad_pcb from above]

Board: 2 copper layers, 90.0 x 60.0 mm, 73 parts (0 on the bottom side), 42 nets.
