roblim/fused_glass_lighting/hardware/kicad/fgl_g1/fgl_g1.kicad_pcb

## KiCad design hardware/kicad/fgl_g1/fgl_g1.kicad_pcb (2026-10-22)

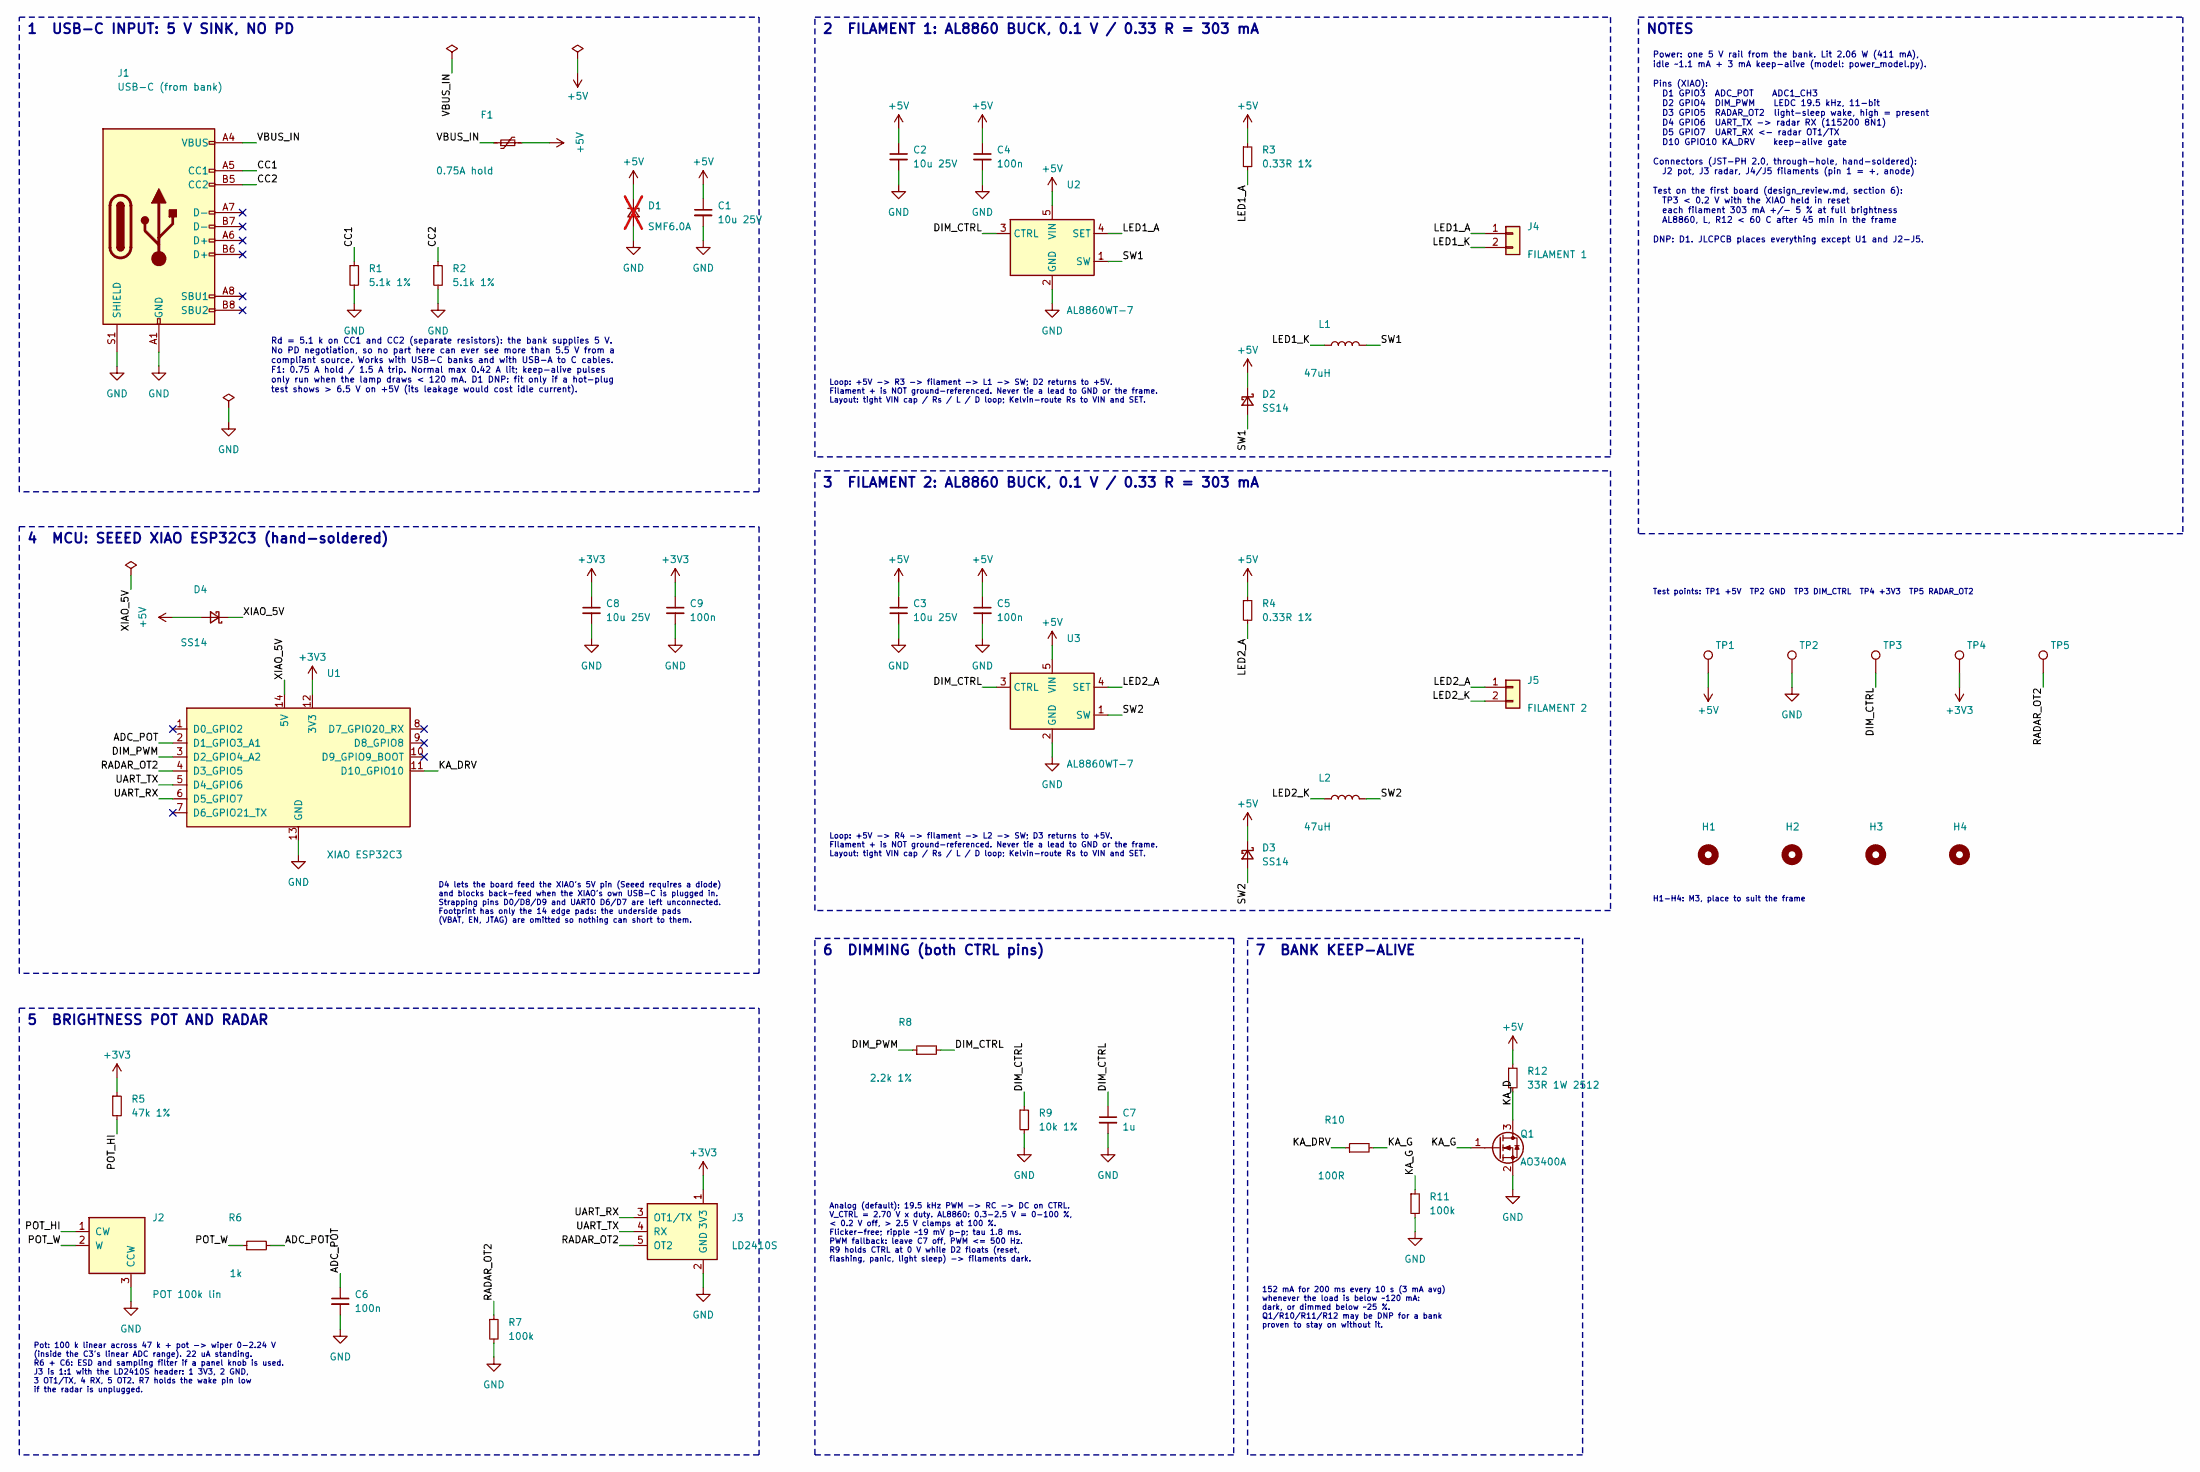
[picture p9: schematic fgl_g1.kicad_sch, Fused Glass Lighting controller]

Parts:
C1, C2, C3, C8: 10u 25V; C_0805_2012Metric; MPN CL21A106KAYNNNE; LCSC C15850
C4, C5, C6, C9: 100n; C_0603_1608Metric; MPN CC0603KRX7R9BB104; LCSC C14663
C7: 1u; C_0603_1608Metric; MPN CL10A105KB8NNNC; LCSC C15849
D1: SMF6.0A; D_SOD-123F; MPN SMF6.0A; LCSC C178260; not fitted
D2, D3, D4: SS14; D_SMA; MPN SS14; LCSC C2480
F1: 0.75A hold; Fuse_1206_3216Metric; MPN 1206L075THYR; LCSC C99563
H1, H2, H3, H4: M3; MountingHole_3.2mm_M3
J1: USB-C (from bank); USB_C_Receptacle_HRO_TYPE-C-31-M-12; MPN TYPE-C-31-M-12; LCSC C165948
J2: POT 100k lin; JST_PH_S3B-PH-K_1x03_P2.00mm_Horizontal; MPN S3B-PH-K-S(LF)(SN); LCSC C157929
J3: LD2410S; JST_PH_S5B-PH-K_1x05_P2.00mm_Horizontal; MPN S5B-PH-K-S(LF)(SN); LCSC C157923
J4: FILAMENT 1; JST_PH_S2B-PH-K_1x02_P2.00mm_Horizontal; MPN S2B-PH-K-S(LF)(SN); LCSC C173752
J5: FILAMENT 2; JST_PH_S2B-PH-K_1x02_P2.00mm_Horizontal; MPN S2B-PH-K-S(LF)(SN); LCSC C173752
L1, L2: 47uH; L_Sunlord_SWPA6045S; MPN SWPA6045S470MT; LCSC C36414
Q1: AO3400A; SOT-23; MPN AO3400A; LCSC C20917
R1, R2: 5.1k 1%; R_0603_1608Metric; MPN 0603WAF5101T5E; LCSC C23186
R3, R4: 0.33R 1%; R_1206_3216Metric; MPN 1206W4F330LT5E; LCSC C25337
R5: 47k 1%; R_0603_1608Metric; MPN 0603WAF4702T5E; LCSC C25819
R6: 1k; R_0603_1608Metric; MPN 0603WAF1001T5E; LCSC C21190
R7, R11: 100k; R_0603_1608Metric; MPN 0603WAF1003T5E; LCSC C25803
R8: 2.2k 1%; R_0603_1608Metric; MPN 0603WAF2201T5E; LCSC C4190
R9: 10k 1%; R_0603_1608Metric; MPN 0603WAF1002T5E; LCSC C25804
R10: 100R; R_0603_1608Metric; MPN 0603WAF1000T5E; LCSC C22775
R12: 33R 1W 2512; R_2512_6332Metric; MPN 25121WF330JT4E; LCSC C53728
TP1: +5V; TestPoint_Pad_D1.5mm
TP2: GND; TestPoint_Pad_D1.5mm
TP3: DIM_CTRL; TestPoint_Pad_D1.5mm
TP4: +3V3; TestPoint_Pad_D1.5mm
TP5: RADAR_OT2; TestPoint_Pad_D1.5mm
U1: XIAO ESP32C3; XIAO_ESP32C3_Castellated; MPN 113991054
U2, U3: AL8860WT-7; TSOT-23-5; MPN AL8860WT-7; LCSC C125330

Connections:
+3V3: C8.1, C9.1, J3.1 (3V3), R5.1, TP4.1, U1.12 (3V3)
+5V: C1.1, C2.1, C3.1, C4.1, C5.1, D1.1 (K), D2.1 (K), D3.1 (K), D4.2 (A), F1.2, R3.1, R4.1, R12.1, TP1.1, U2.5 (VIN), U3.5 (VIN)
/ADC_POT: C6.1, R6.2, U1.2 (D1_GPIO3_A1)
/CC1: J1.A5 (CC1), R1.1
/CC2: J1.B5 (CC2), R2.1
/DIM_CTRL: C7.1, R8.2, R9.1, TP3.1, U2.3 (CTRL), U3.3 (CTRL)
/DIM_PWM: R8.1, U1.3 (D2_GPIO4_A2)
/KA_D: Q1.3 (D), R12.2
/KA_DRV: R10.1, U1.11 (D10_GPIO10)
/KA_G: Q1.1 (G), R10.2, R11.1
/LED1_A: J4.1, R3.2, U2.4 (SET)
/LED1_K: J4.2, L1.1
/LED2_A: J5.1, R4.2, U3.4 (SET)
/LED2_K: J5.2, L2.1
/POT_HI: J2.1 (CW), R5.2
/POT_W: J2.2 (W), R6.1
/RADAR_OT2: J3.5 (OT2), R7.1, TP5.1, U1.4 (D3_GPIO5)
/SW1: D2.2 (A), L1.2, U2.1 (SW)
/SW2: D3.2 (A), L2.2, U3.1 (SW)
/UART_RX: J3.3 (OT1/TX), U1.6 (D5_GPIO7)
/UART_TX: J3.4 (RX), U1.5 (D4_GPIO6)
/VBUS_IN: F1.1, J1.A4 (VBUS), J1.A9 (VBUS), J1.B4 (VBUS), J1.B9 (VBUS)
/XIAO_5V: D4.1 (K), U1.14 (5V)
GND: C1.2, C2.2, C3.2, C4.2, C5.2, C6.2, C7.2, C8.2, C9.2, D1.2 (A), J1.A1 (GND), J1.A12 (GND), J1.B1 (GND), J1.B12 (GND), J1.S1 (SHIELD), J2.3 (CCW), J3.2 (GND), Q1.2 (S), R1.2, R2.2, R7.2, R9.2, R11.2, TP2.1, U1.13 (GND), U2.2 (GND), U3.2 (GND)

Notes on the sheet:
NOTES
3 FILAMENT 2: AL8860 BUCK, 0.1 V / 0.33 R = 303 mA
1 USB-C INPUT: 5 V SINK, NO PD
Test points: TP1 +5V TP2 GND TP3 DIM_CTRL TP4 +3V3 TP5 RADAR_OT2
Rd = 5.1 k on CC1 and CC2 (separate resistors): the bank supplies 5 V. No PD negotiation, so no part here can ever see more than 5.5 V from a compliant source. Works with USB-C banks and with USB-A to C cables. F1: 0.75 A hold / 1.5 A trip. Normal max 0.42 A lit; keep-alive pulses only run when the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
D4 lets the board feed the XIAO's 5V pin (Seeed requires a diode) and blocks back-feed when the XIAO's own USB-C is plugged in. Strapping pins D0/D8/D9 and UART0 D6/D7 are left unconnected. Footprint has only the 14 edge pads: the underside pads (VBAT, EN, JTAG) are omitted so nothing can short to 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
H1-H4: M3, place to suit the frame
Power: one 5 V rail from the bank. Lit 2.06 W (411 mA), idle ~1.1 mA + 3 mA keep-alive (model: power_model.py). Pins (XIAO): D1 GPIO3 ADC_POT ADC1_CH3 D2 GPIO4 DIM_PWM LEDC 19.5 kHz, 11-bit D3 GPIO5 RADAR_OT2 light-sleep wake, high = present D4 GPIO6 UART_TX -> radar RX (115200 8N1) D5 GPIO7 UART_R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
5 BRIGHTNESS POT AND RADAR
4 MCU: SEEED XIAO ESP32C3 (hand-soldered)
7 BANK KEEP-ALIVE
Loop: +5V -> R4 -> filament -> L2 -> SW; D3 returns to +5V. Filament + is NOT ground-referenced. Never tie a lead to GND or the frame. Layout: tight VIN cap / Rs / L / D loop; Kelvin-route Rs to VIN and SET.
Analog (default): 19.5 kHz PWM -> RC -> DC on CTRL. V_CTRL = 2.70 V x duty. AL8860: 0.3-2.5 V = 0-100 %, < 0.2 V off, > 2.5 V clamps at 100 %. Flicker-free; ripple ~19 mV p-p; tau 1.8 ms. PWM fallback: leave C7 off, PWM <= 500 Hz. R9 holds CTRL at 0 V while D2 floats (reset, flashing, panic, light 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
152 mA for 200 ms every 10 s (3 mA avg) whenever the load is below ~120 mA: dark, or dimmed below ~25 %. Q1/R10/R11/R12 may be DNP for a bank proven to stay on without it.
Loop: +5V -> R3 -> filament -> L1 -> SW; D2 returns to +5V. Filament + is NOT ground-referenced. Never tie a lead to GND or the frame. Layout: tight VIN cap / Rs / L / D loop; Kelvin-route Rs to VIN and SET.
Pot: 100 k linear across 47 k + pot -> wiper 0-2.24 V (inside the C3's linear ADC range). 22 uA standing. R6 + C6: ESD and sampling filter if a panel knob is used. J3 is 1:1 with the LD2410S header: 1 3V3, 2 GND, 3 OT1/TX, 4 RX, 5 OT2. R7 holds the wake pin low if the radar is unplugged.
2 FILAMENT 1: AL8860 BUCK, 0.1 V / 0.33 R = 303 mA
6 DIMMING (both CTRL pins)

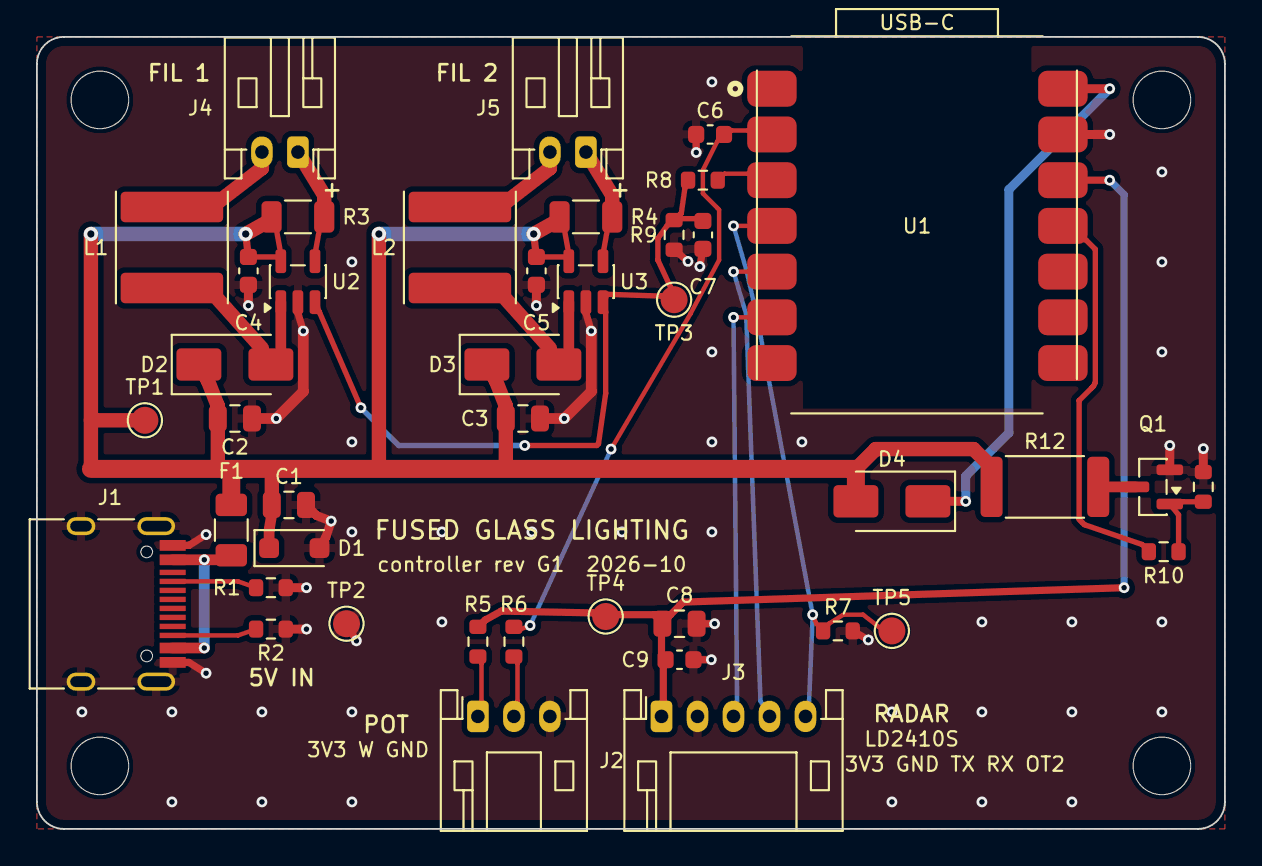
[picture p10: board fgl_g1.kicad_pcb from above]

Board: 2 copper layers, 66.0 x 44.0 mm, 46 parts (0 on the bottom side), 24 nets.
