roblim/fused_glass_lighting/(commit log)

2026-10-07 Rev F firmware: radar presence, light sleep, powerbank keep-alive
    Rework main.c for the Rev F hardware: HLK-LD2410S radar presence on
    OT2, PWM dimming of the two CN5711 drivers through their commoned CE
    pins, light sleep between events, and a dummy-load pulse that keeps
    the USB powerbank from shutting off.
    Opt the output pins out of sleep GPIO isolation so CE no longer floats
    high and runs the filaments at full current during light sleep.
    Add docs/hardware.md with the circuit design, BOM, wiring table and
    bring-up procedure, and archive the previous wall-supply main.c.
    Tune sdkconfig for light sleep (IRAM sleep path, flash power-down) and
    enable -Wall -Wextra plus the exception decoder in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
2026-10-22 Rev G1 controller PCB, Rev F schematic and design review
    Add hardware/ with the KiCad 9 projects: fgl_g1 (new controller PCB,
    schematic, layout, BOMs and JLCPCB gerbers/CPL) and fgl_rev_f (the
    prototype as built, documentation only). Add the scripts that generate
    the schematics, verify exported netlists against hand-written intent,
    build the BOMs and model power/runtime, plus the G1 layout scripts.
    Add docs/design_review.md covering the firmware, Rev F and G1. Rework
    docs/hardware.md around G1 and archive the Rev F version to
    docs/archive/hardware_rev_f.md.
    Ignore __pycache__ and KiCad backups, lock files and per-user state.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
2026-10-25 Rev G2 controller: schematic, layout, fab files and 3D models
    G2 replaces G1: a TPS61500 SEPIC drives one series filament string
    through four Degson push-in ports (244/488 mA ceiling, 5 W cap with
    string-voltage sense), with a pot power switch that also releases the
    USB-C attach, and a socketed XIAO ESP32C3 and LD2410S radar.
    - Schematic (KiCad 9 master), ERC clean; netlist and PCB pad nets
    verified against g2_expected.py (verify_netlist.py, verify_pcb.py).
    - 74 x 58 mm 2-layer layout (tools/layout_g2/), DRC 0 errors and
    0 unconnected; JLCPCB gerbers, drill, BOM and CPL in fgl_g2/jlcpcb/.
    - Makers' 3D models in fgl_g2/3dmodels/ (Degson, Hi-Link, JLCPCB/
    EasyEDA library, XIAO from Grab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
2026-10-25 Add G1 and G2 netlist, power and BOM audits
    docs/g1_netlist_audit.md: the Oct 22 audit of Rev G1, copied from the
    Project.
    docs/g2_netlist_audit.md: independent audit of Rev G2 at 99dcb6d.
    Schematic and PCB agree pad for pad; pinouts match the TPS61500,
    ESP32-C3 and LD2410S datasheets. Main finding (H1): GPIO20 has an
    internal pull-up at reset, so EN sits near 2.2 V and the driver runs at
    full ceiling during boot and USB flashing; fix is R18 100k -> 2.2k.
    Also: CPL omits the JST_PH_S 180 deg correction (M1), output caps at
    1.6x of OVP (M2), thin SW margin at OVP (M3), firmware guards for
    hot-connect and reversed filaments (M4).
    Claude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
2026-10-25 G2: fix the Oct 24 audit findings; G2 firmware build with string guards
    Hardware (schematic, PCB, fab outputs):
    - R18 100k -> 2.2k so EN stays low through reset and USB flashing (H1)
    - C5 10u 100V X7S 1210, C6 100n 100V (M2)
    - R15 120k -> 110k: OVP 27.7 V, switch <= 35.1 V worst case (M3)
    - JP1 solder jumper -> 1x3 2.54 mm header with a shunt (L1)
    - Q2 soft start: R14 10k + new C16 100n gate-source (L2)
    - Silkscreen: exact JP1 currents, pin-1 mark, "SWITCH OFF BEFORE WIRING PORTS"
    - BOM tidy: U1 once, shunt line, voltages/tolerances in values;
    upload BOM in jlcpcb/ refreshed and kept in sync by build.sh
    Firmware (src/main.c, platformio env seeed_xiao_esp32c3_g2):
    - G2 pins, analog dimming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
2026-10-27 G2 layout DFM pass after Gemini's layout review (D17)
    - 25 fan-out vias moved (with their stubs) to >= 0.25 mm from SMD pads:
    C3/C7/C8/R18 from the review, plus a board-wide sweep (incl. a via
    0.06 mm from C5 left by the 1210 change). Three stay closer (no room).
    - J3/J4 pin 2 (GND): thermal reliefs instead of solid. J4 spokes at 45;
    J3: RADAR_OT2_C run lowered 1 mm and two GND vias under the socket.
    - 10 GND stitching vias between the XIAO and U2.
    - F.Fab text tidied; new assembly drawing fgl_g2_assembly.pdf.
    - Gerbers/drill regenerated; CPL and position file unchanged.
    DRC 0 errors / 0 unconnected; verify_pcb passes.
    - Docs: Gemini's report saved as docs/g2_layout_dfm_audit.md with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
2026-10-27 G2: JP2 radar/manual mode jumper (D18)
    - JP2 1x3 header (same part as JP1) on XIAO D8/GPIO8: shunt 1-2 = manual
    (radar ignored, lit whenever switched on, pot dims), 2-3 or none = radar.
    - No external pull-up (no room by J10): the firmware enables GPIO8's
    internal pull-up and reads the jumper at power-on.
    - Layout: JP2 at (114.54, 130), B.Cu route from J10 pin 2, silkscreen
    legend; C11 reference nudged. DRC 0/0, verify_pcb 184 pads.
    - Netlist 42 nets / 175 connections / 73 parts; fab outputs, BOM (61
    placements, two loose shunts), assembly drawing, renders regenerated.
    - Firmware: manual mode in the G2 build (start check, guards and 5 W cap
    unchanged; no off-delay or radar sleep). C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
2026-10-28 G2: 90 x 60 mm relayout, horizontal-entry ports, R29 pull-up (D19)
    - J5-J8: JILN JL212R-35003B01 push-in blocks (Degson DG212R-THR fits the
    same footprint): wire entry parallel to the board at the top edge, release
    buttons on the wire face. New fgl.pretty footprint and a simplified 3D
    model (tools/make_port_step.py).
    - R29 10k pull-up on RADAR_MODE (D8); C16 0402 -> 0603 (C14663).
    - Board 74 x 58 -> 90 x 60 mm, laid out with tools/layout_g2b: parts spread
    for rework (min courtyard gap 0.72 mm, median ~1 mm, was 0.3 mm), M3 holes
    in the corners, TP5 clear of the radar, FB routed Kelvin to R21, no via
    within 0.25 mm of any SMD pad.
    - ERC 0 errors; netlist 42 nets / 177 connections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
2026-10-28 G2: silkscreen reference designator for every part
    C2, C4, R13, R15 and R16 had clear spots from the D19 layout script but
    stayed on F.Fab (carried over from the 74 x 58 mm board); C15 and JP2
    were left off by choice. All seven are now on F.Silkscreen in 0.8 mm
    text beside their parts; only the mounting holes have no reference.
    - layout_g2b/refspots.py finds clear spots (pads, silk text and lines);
    apply_refs.py copies them into the board without re-serialising it
    - emit.py now moves a placed reference back to F.SilkS
    - DRC unchanged (0 errors, 0 unconnected, 71 warnings); verify_pcb
    passes; only F_Silkscreen.gto changed among gerbers/drill; position
    file identical
    - assembly drawing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
2026-10-28 G2: PADS-PCB netlist for Pinscope
    Pinscope reads PADS-PCB or EDIF netlists, not KiCad's XML .net.
    make_pads_netlist.py writes fgl_g2_pads.asc in the layout of KiCad's
    PADS export (74 parts, 42 nets; the 11 single-pin nets for unconnected
    pins are left out). A round-trip parse matches the KiCad netlist net
    for net.
    Claude-Session: https://claude.ai/code/session_013HVPKWJHmpHbXpMbmhYHhv
2026-10-28 G2: datasheet links on every purchased part
    Flux flagged parts on generic KiCad symbols as missing a datasheet; no
    placed part had its Datasheet field set. set_datasheets.py fills it
    (schematic and board) from each part's LCSC number with a direct PDF
    link (datasheet.lcsc.com; TI's copy for TPS61500; Seeed wiki for the
    XIAO). Test points and mounting holes are left empty.
    U1's MPN is now just 113991054 (ordering note moved to Note) and the
    shunt's MPN is 2.54, so MPN lookups (Pinscope, Flux) find them.
    Nets and footprints unchanged; verify_netlist and verify_pcb pass; ERC
    0 errors; DRC same 71 warnings; gerbers identical apart from dates.
    Regenerated netlist, schematic PDF, bom.csv, assemb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
2026-10-29 G2-T6: restore the USB-A hot-plug measurement that decides D1
    G1's test T9 scoped +5V during a live USB-A plug-in and fitted the TVS
    (D1) above 6.5 V; G2's rewrite of the test list kept the USB-A cable but
    dropped the measurement and the rule. G2-T6 now says how to measure
    (TP1/TP2, single-shot at 5.5 V, ten plug-ins with the switch on and
    ten off, VBUS_F for reference) and when to fit D1.
    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
2026-10-29 G2: act on Flux's schematic review
    - Section 2 (SEPIC) redrawn with wires instead of a label on every pin;
    one label per net, labels only where nets leave the section
    - Label overlaps cleared: GND at JP1/JP2, VBUS_IN power flag, F1/Q2
    reference and value
    - Silkscreen: "Remove shunt to flash" under the JP2 legend (GPIO8 low
    blocks download boot); same instruction in the flashing step
    - G2-T6: scope the XIAO 5V pin (limit 6.0 V, XC6210) in both plug
    orientations; D1 cannot hold that, so a failure means an input OVP
    cut-off in G3. G2-T12: try a USB flash with the JP2 shunt on
    - docs/g2_flux_schematic_review.md: Flux's findings with resolutions
    KiCad netlist identical (nets, names, pa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
2026-10-29 G2: act on Flux's layout review: tighter switching loop, J1 vias off the shield
    C4 under L1, D5 vertical below C4, C5/C6 beside D5's cathode over solid
    B.Cu ground: loop area about 74 -> 52 mm^2. Router keeps vias 0.25 mm from
    through-hole pads too, which moves J1's GND vias from 0.12 to 0.35 mm off
    the shield pads. DRC 0 errors / 0 unconnected; verify_pcb passes; netlist
    and BOM unchanged. Fab files, CPL, assembly drawing, renders regenerated.
    Flux's review saved with a resolution for each finding.
    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
2026-10-29 G2: silkscreen clarity pass: every reference beside its own part
    R19's reference sat beside C9. labelcheck.py measures each reference
    against its own and its nearest other part; 20 references moved (C9/R19/
    R16/R15 in one row under their parts, the XIAO resistor row vertical, JP2,
    R12, R13, C3, C4, C5, C7, R29), three cramped pin legends spread, and all
    top-silkscreen text strokes raised from 0.12 to JLCPCB's 0.15 mm minimum.
    Only F_Silkscreen.gto changed; DRC 0 errors / 0 unconnected.
    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
2026-10-29 G2: move board name and port-wiring warning to the clear top-right corner
    They were cramped at the top left between J5, TP3, TP4 and C11. Now between
    J8 and the H2 hole: name and revision on top, warning below at 1.0 mm.
    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
2026-10-29 docs: G2 ordering steps: Economic PCBA, confirmation options, D1 note brought up to date
    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
2026-10-29 G2: fuse to 2 A hold (55 C derating), JLCPCB placement corrections, Flux second pass
    F1: SMD1812B150TF/8 (1.06 A hold at 55 C) would trip at the 5 W cap in a
    warm frame; now SMD1812B200TF/16 (C269145, ~1.58 A at 55 C), same 1812
    footprint. make_cpl.py: every part at its pad-bbox centre (JLCPCB's origin;
    KiCad's is pin 1 for headers, sockets, JST, ports, off-centre for the USB-C)
    and rotations keyed by LCSC part, checked against JLCPCB's first preview:
    J4/J5-J8 +180, JP1/JP2 +270, J1 0, SOT-23 180. Docs: supported strings up to
    24 V total, USB-C 1.5 A source for full power, closed-frame G2-T2 run, new
    G2-T14 radar through the glass, preview checklist; Flux's second pass saved
    with resolutions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
2026-10-30 G2 JLCPCB files: a BOM + CPL pair per port variant (DEGSON, JILN)
    make_cpl.py writes fgl_g2-{bom,cpl}-jlcpcb-degson.csv (DG212R, C7603454, the
    schematic's part) and -jiln.csv (JL212R, C2962951); they differ only in
    J5-J8's LCSC number. Gerbers are shared. Old unsuffixed files removed.
    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
2026-10-30 docs: G2 summary table: fuse is 2 A hold since D12's change
    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
2026-10-30 docs: G2 off-board parts sourcing; U1 MPN is the pre-soldered XIAO
    - New docs/g2_sourcing.md: where to buy the pot, knob, filaments, XIAO,
    LD2410S, USB-C panel extension and power bank for 5-10 frames, the
    recessed pot geometry for the 20 mm frame wall, and bank safety notes
    - Pot: Same Sky PTN09S1-H100115K1B (knurled shaft) with a push-on Cliff
    K21 knob, so the knob can sit in a recess with no set screw to reach
    - U1 MPN 113991054 (no headers) -> 102010633 (pre-soldered) in the
    schematic, netlist, BOM, gen_g2.py and g2_expected.py; PDF re-exported
    - New bring-up test G2-T15: the chosen bank in the closed frame
    Claude-Session: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
2026-10-30 docs: cheaper USB-C panel extension and power bank in the sourcing guide
    - Panel extension: generic 2.5 A screw-mount USB-C extension, about $4.60
    each in a 2-pack (power only, but it must pass CC); check each cable
    with a PD charger before fitting
    - Bank: CUKTECH PB200N 20,000 mAh, built-in USB-C cable, 29 mm thick,
    $29.99. Slim 25 Ah banks from known brands start at about $70
    (CUKTECH LPB252N, UGREEN PB552), so 20 Ah is the economical choice;
    runtime 7.2 instead of about 9 days at 4 h/day
    - Per-frame cost about $58 (was about $108)
    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
2026-10-30 docs: sourcing guide with the final picks and cost per build
    - Final picks: CUKTECH PB200N bank (UGREEN PB536 as backup) and the
    FdcLixuvol 2-pack USB-C panel extension
    - Prices rechecked 2026-10-30; per-build tally of the off-board parts:
    $58.02 per build ($63.02 with the backup bank), $612.89 for 10 builds
    with spares, by vendor
    - Order plan: one bank and one cable pack first, for G2-T15
    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
2026-10-30 docs: sourcing guide gives the cost per build at 1, 5 and 10 builds
    $76.79 / $60.83 / $58.02 per build (DigiKey price breaks, whole packs,
    AliExpress shipping and the wire roll spread over the run); +$5.00 with
    the UGREEN PB536 backup bank.
    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
2026-10-30 docs: JLCPCB board quotes added to the cost per build
    5 boards $103.39, 10 boards $142.98, shipping and duty (DDP) and coupons
    included. Total per build including the board: $180.18 / $81.51 / $72.32
    at 1 / 5 / 10 builds; $755.87 for 10 builds with spares.
    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
2026-10-31 docs: drop the 1-build cost column (JLCPCB minimum is 5 boards)
    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
2026-11-01 docs: slimmer pot knob (Cliff KMK10E, 10.7 mm) and a through-hole plate mount
    - Knob: Cliff KMK10E black (FC7257), push-on knurled aluminium, 10.7 x
    19 mm, replaces the 19.3 mm K21 and its cap. Smallest knobs for the 6 mm
    18-spline shaft compared (KMK10, K86R, K88S)
    - Recess: a 12 mm through-hole with a 14 x 3 mm nut counterbore inside; the
    pot is nutted to a small 1.5 mm plate at the bench (a 12 mm hole leaves
    no room for a socket), knob pushed on, plate screwed inside. Knob about
    4.5 mm proud (6 mm with the plate set flush)
    - Costs: $82.97 / $73.71 per build at 5 / 10 builds; $769.77 for 10 with
    spares
    Claude-Session: htt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
2026-11-01 docs: pot recess - the 12 mm through-hole takes the nut; counterbore optional
    The 7.3 mm hole is only in the mounting plate. Clarify the knob-size
    wording to compare against the 12 mm frame hole.
    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
2026-11-01 docs: pot mounts directly to the frame (captive nut), no plate
    Outside: 12 mm bore 15.5 deep, a hex pocket for the pot's nut (2 mm),
    a 2.5 mm web with a 7.3 mm bushing hole. The nut is pressed into the hex,
    the pot is screwed into it from inside (blue threadlocker, tab nipped off),
    then the knob is pushed on: about 6 mm proud. No tool down the hole.
    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
2026-11-01 docs: add the JP1/JP2 shunts (Sullins SPC02SYAN) to the sourcing order
    They are loose parts, not in the JLCPCB BOM. 25 for 10 builds at DigiKey.
    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
2026-11-01 docs: pot lead is Adafruit 3955, not 4045
    The 4045's connector is an in-line socket that mates with another cable,
    not with the J2 board header. The 3955 has the board-mating JST PH housing
    (cut its header pins off). +$0.55 per build: $83.58 / $74.31 at 5 / 10.
    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
