roblim/fused_glass_lighting/(notices)

Notices in the files:
parts and their libraries:
Seeed XIAO ESP32C3, castellated edge pads only (1-14). Pad geometry from Seeed OPL_Kicad_Library XIAO-ESP32-C3-SMD (commit b0035c5, CC BY-SA 4.0). Underside pads (JTAG, EN, VBAT) deliberately omitted: keep copper and vias out from under the module.
